syntheticAIdata/JBR-001/schematics/JBR-001-schematics.png

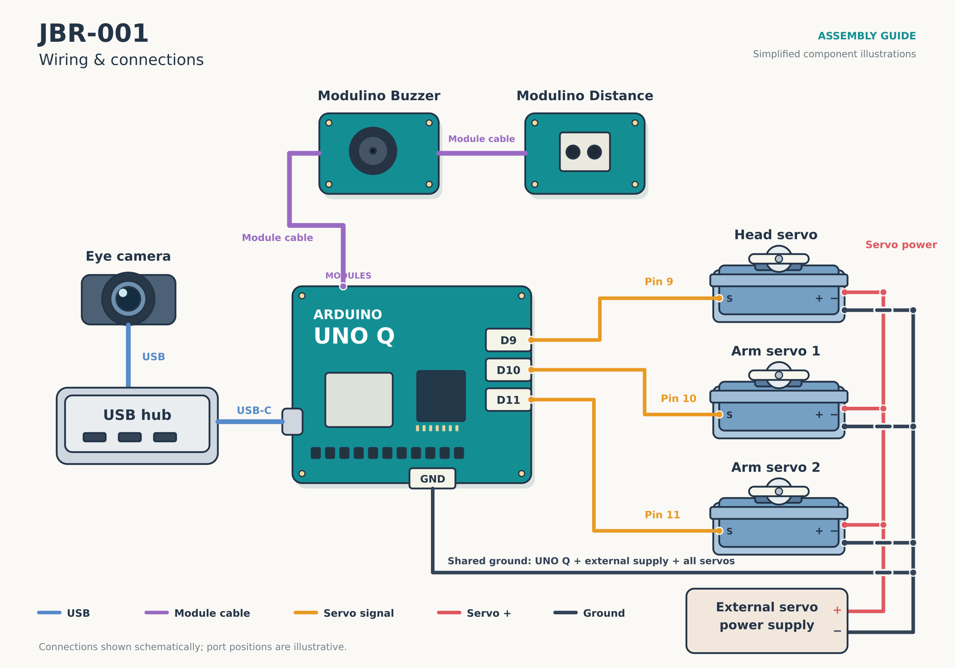
schematics/JBR-001-schematics.png
