syntheticAIdata/JBR-001/3d-printable-files/right-leg/Right_Leg_Main_White.stl

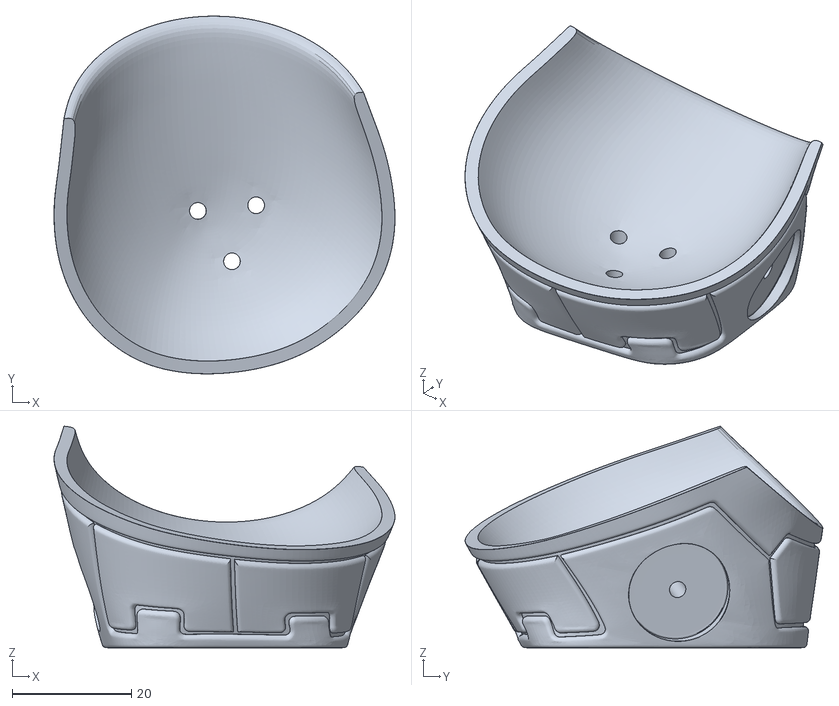
[picture p3: CAD file, 2026-09-22]
3d-printable-files/right-leg/Right_Leg_Main_White.stl
57.3 x 60.1 x 37.2
