syntheticAIdata/JBR-001/3d-printable-files/body/Body_Frame_Front_White.stl

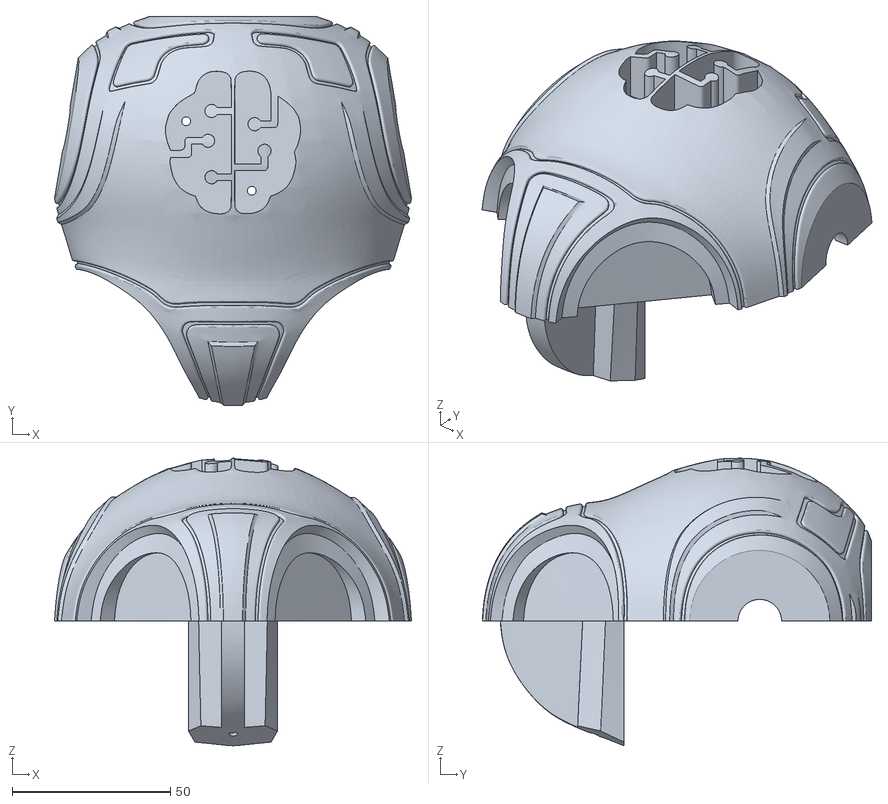
[picture p4: CAD file, 2026-10-07]
3d-printable-files/body/Body_Frame_Front_White.stl
112.8 x 122.9 x 90.8
