syntheticAIdata/JBR-001/3d-printable-files/frame/Frame_Cage_Body_Bottom.stl

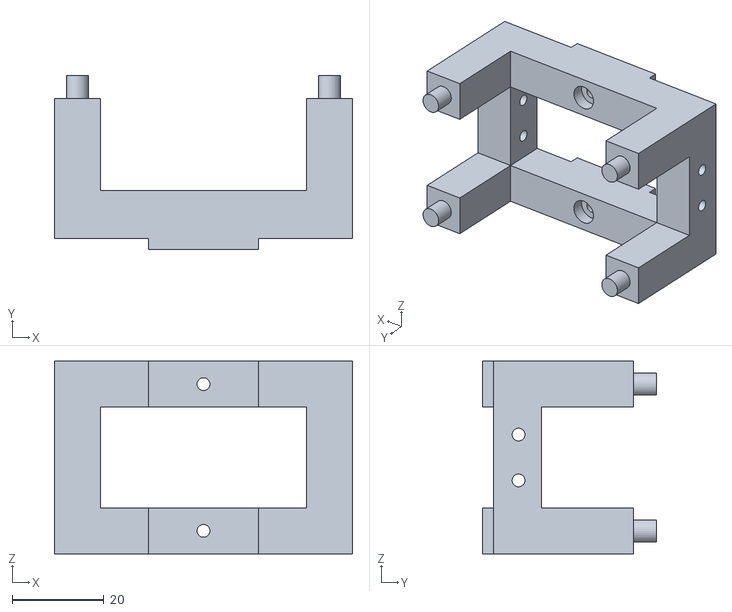
[picture p5: CAD file, 2026-10-07]
3d-printable-files/frame/Frame_Cage_Body_Bottom.stl
65.0 x 37.9 x 42.0
