syntheticAIdata/JBR-001/3d-printable-files/head/Head_Ear_Right_Blue.stl

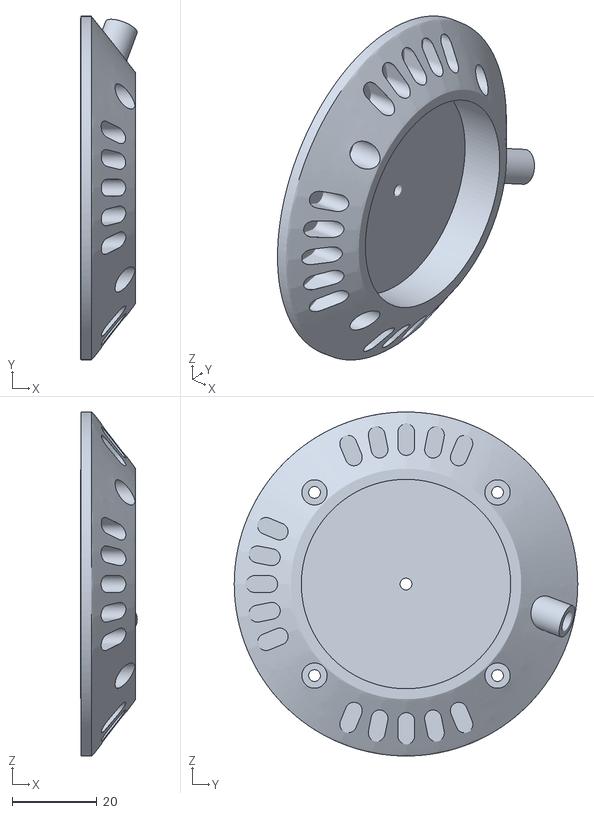
[picture p6: CAD file, 2026-09-22]
3d-printable-files/head/Head_Ear_Right_Blue.stl
13.4 x 81.3 x 81.4
