syntheticAIdata/JBR-001/3d-printable-files/left-arm/Left_Arm_Forearm_White.stl

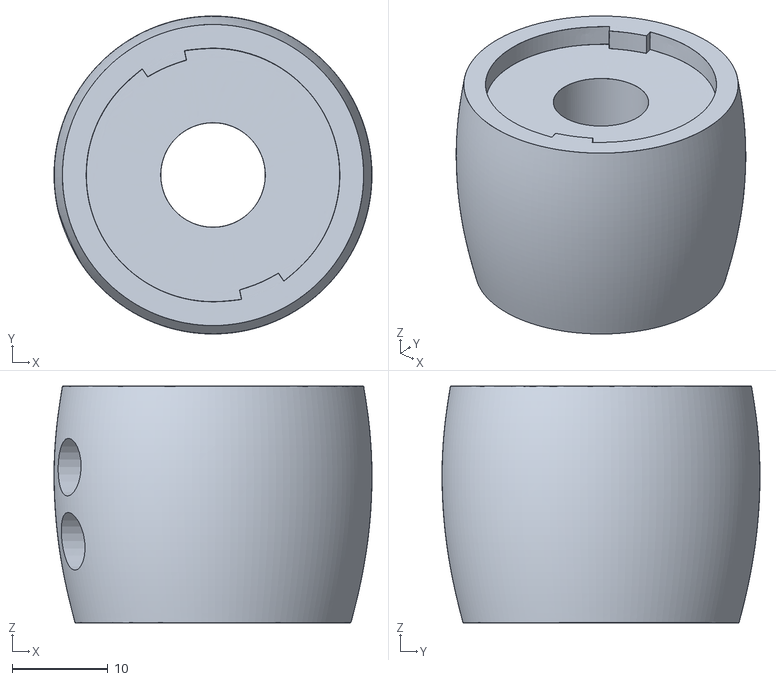
[picture p7: CAD file, 2026-09-22]
3d-printable-files/left-arm/Left_Arm_Forearm_White.stl
33.1 x 33.1 x 24.7
