syntheticAIdata/JBR-001/3d-printable-files/left-leg/Left_Leg_Cap_White.stl

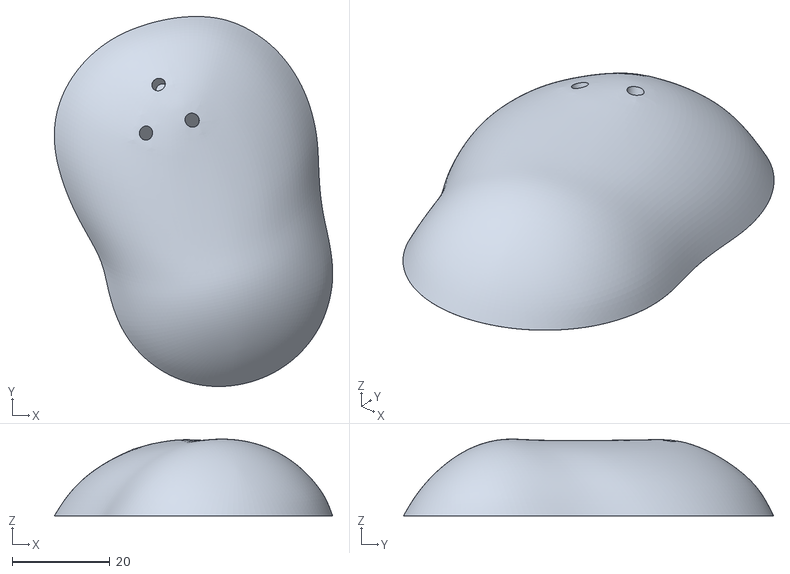
[picture p8: CAD file, 2026-09-22]
3d-printable-files/left-leg/Left_Leg_Cap_White.stl
56.8 x 75.5 x 15.7
