syntheticAIdata/JBR-001/3d-printable-files/right-arm/Right_Arm_Ring_Bottom_Blue.stl

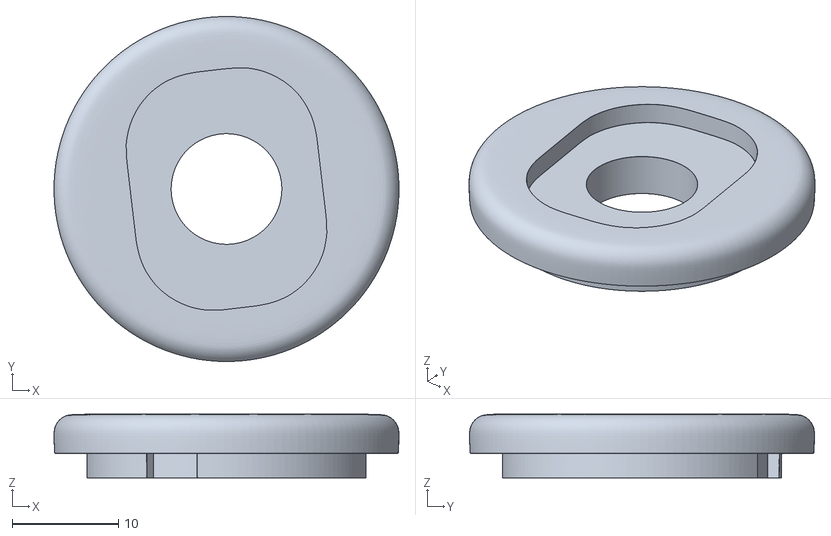
[picture p9: CAD file, 2026-09-22]
3d-printable-files/right-arm/Right_Arm_Ring_Bottom_Blue.stl
32.5 x 32.5 x 6.03
