syntheticAIdata/JBR-001/3d-printable-files/right-leg/Right_Leg_Knee_Ring_Blue.stl

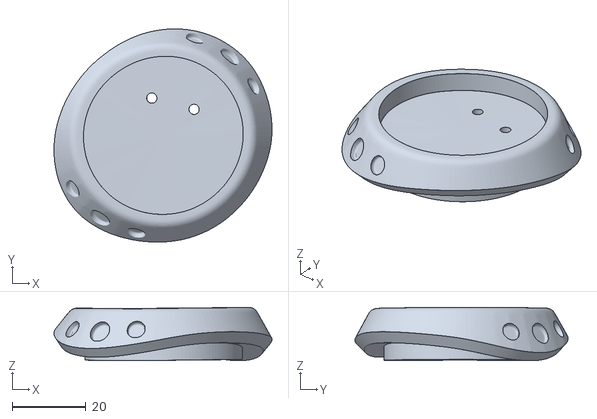
[picture p10: CAD file, 2026-09-22]
3d-printable-files/right-leg/Right_Leg_Knee_Ring_Blue.stl
59.1 x 57.8 x 14.5
