syntheticAIdata/JBR-001/3d-printable-files/body/Body_Frame_Back_White.stl

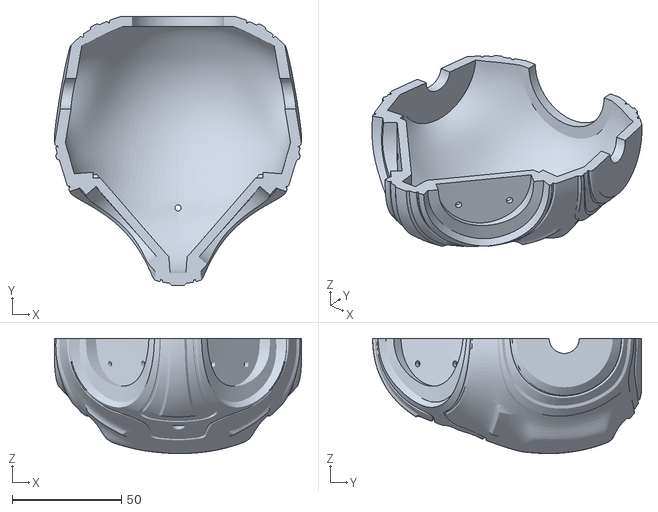
[picture p11: CAD file, 2026-10-07]
3d-printable-files/body/Body_Frame_Back_White.stl
113.1 x 123.0 x 52.7
