syntheticAIdata/JBR-001/3d-printable-files/frame/Frame_Head_Back_Bottom_Left.stl

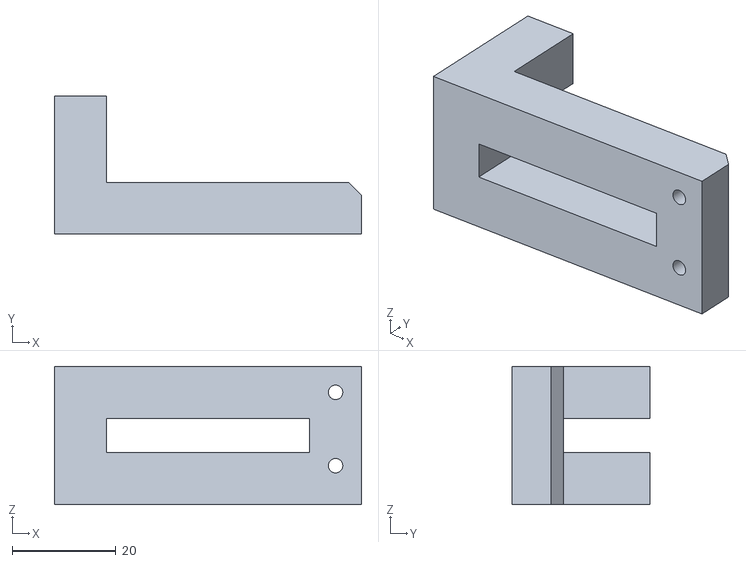
[picture p12: CAD file, 2026-09-22]
3d-printable-files/frame/Frame_Head_Back_Bottom_Left.stl
59.3 x 26.7 x 26.7
