syntheticAIdata/JBR-001/3d-printable-files/head/Head_Front_Right_White.stl

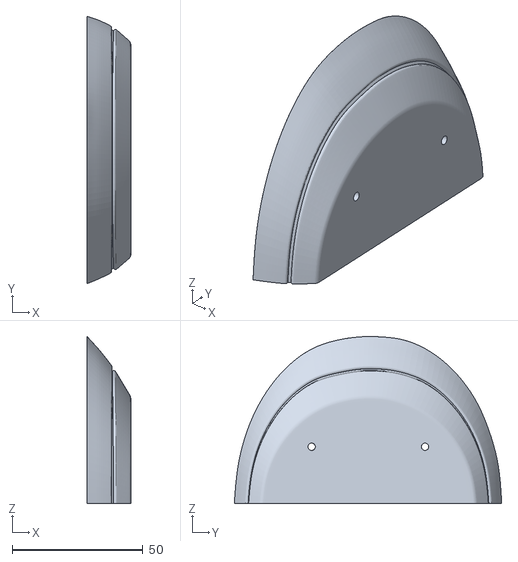
[picture p13: CAD file, 2026-09-22]
3d-printable-files/head/Head_Front_Right_White.stl
16.7 x 102.1 x 63.8
