syntheticAIdata/JBR-001/3d-printable-files/left-arm/Left_Arm_Shoulder_White.stl

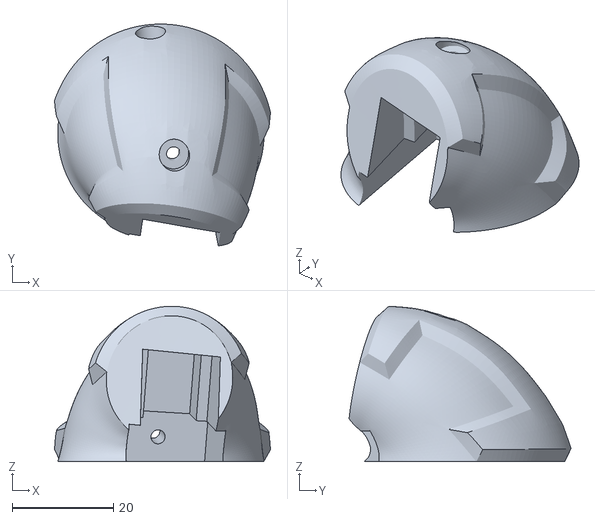
[picture p14: CAD file, 2026-09-22]
3d-printable-files/left-arm/Left_Arm_Shoulder_White.stl
42.6 x 43.8 x 30.7
