syntheticAIdata/JBR-001/3d-printable-files/left-leg/Left_Leg_Base_Blue.stl

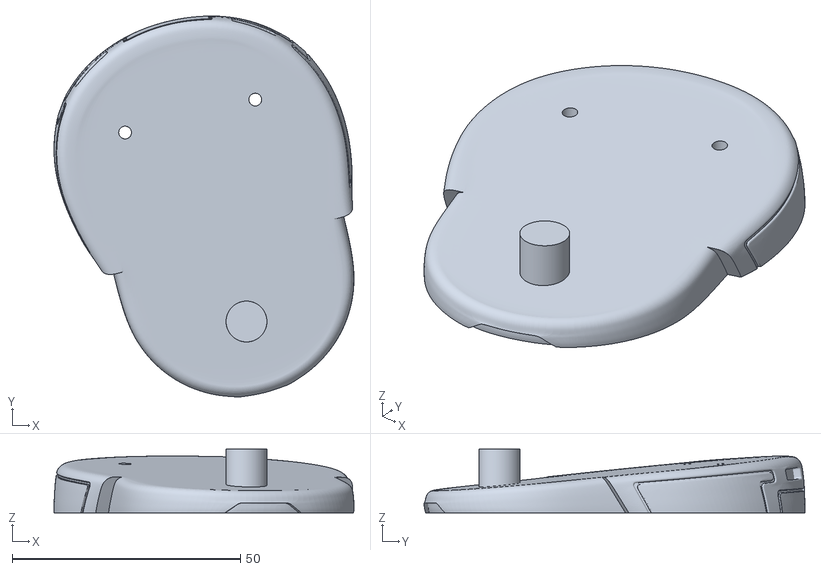
[picture p15: CAD file, 2026-09-22]
3d-printable-files/left-leg/Left_Leg_Base_Blue.stl
65.7 x 83.4 x 13.9
