syntheticAIdata/JBR-001/3d-printable-files/body/Body_Logo_Left_Blue.stl

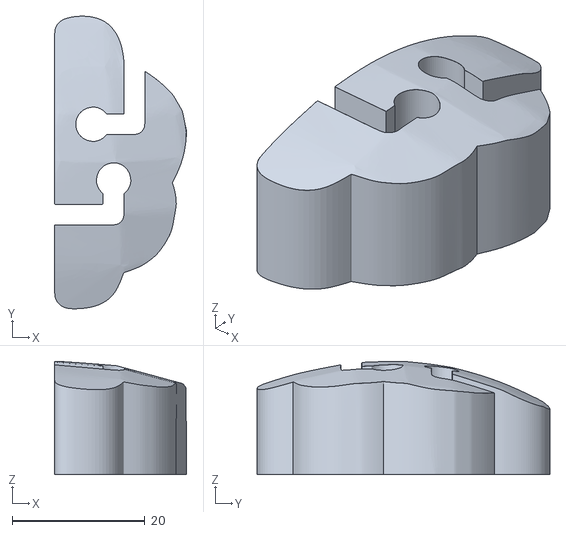
[picture p16: CAD file, 2026-09-22]
3d-printable-files/body/Body_Logo_Left_Blue.stl
19.9 x 44.0 x 17.0
