syntheticAIdata/JBR-001/3d-printable-files/frame/Frame_Holder_Back_Cap_Left_Blue.stl

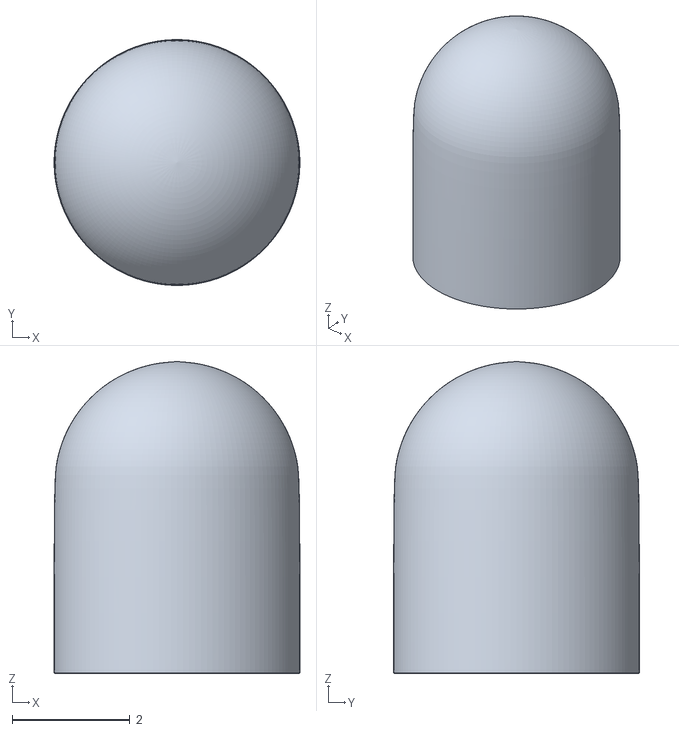
[picture p17: CAD file, 2026-09-22]
3d-printable-files/frame/Frame_Holder_Back_Cap_Left_Blue.stl
4.18 x 4.18 x 5.31
