syntheticAIdata/JBR-001/3d-printable-files/head/Head_Ear_Button_Right_White.stl

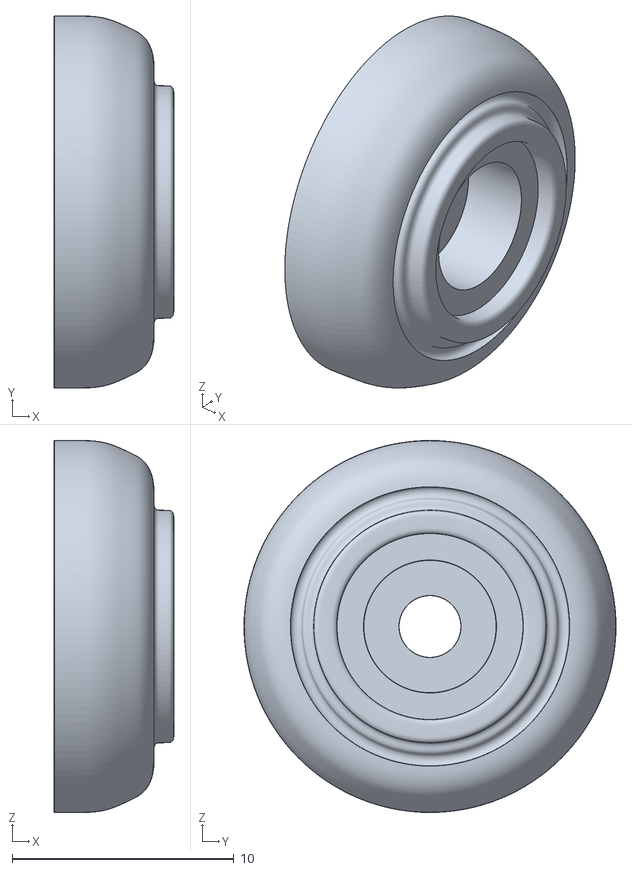
[picture p18: CAD file, 2026-09-22]
3d-printable-files/head/Head_Ear_Button_Right_White.stl
5.40 x 16.8 x 16.8
