syntheticAIdata/JBR-001/3d-printable-files/left-arm/Left_Arm_Shoulder_Pole.stl

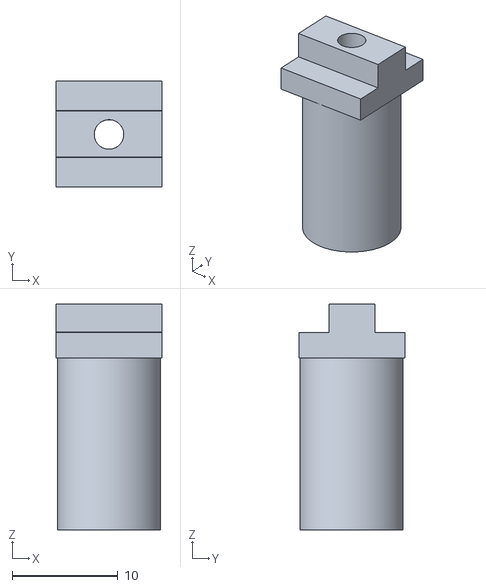
[picture p19: CAD file, 2026-09-22]
3d-printable-files/left-arm/Left_Arm_Shoulder_Pole.stl
10.0 x 10.0 x 21.4
