syntheticAIdata/JBR-001/3d-printable-files/right-arm/Right_Arm_Upper_Arm_Black.stl

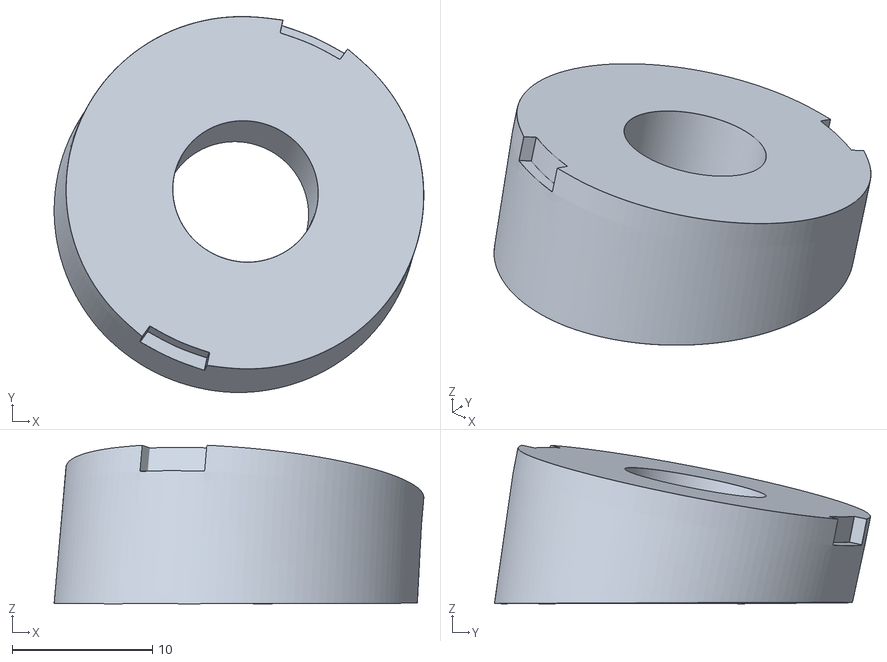
[picture p20: CAD file, 2026-09-22]
3d-printable-files/right-arm/Right_Arm_Upper_Arm_Black.stl
26.3 x 26.8 x 11.3
