syntheticAIdata/JBR-001/3d-printable-files/right-leg/Right_Leg_Knee_Black.stl

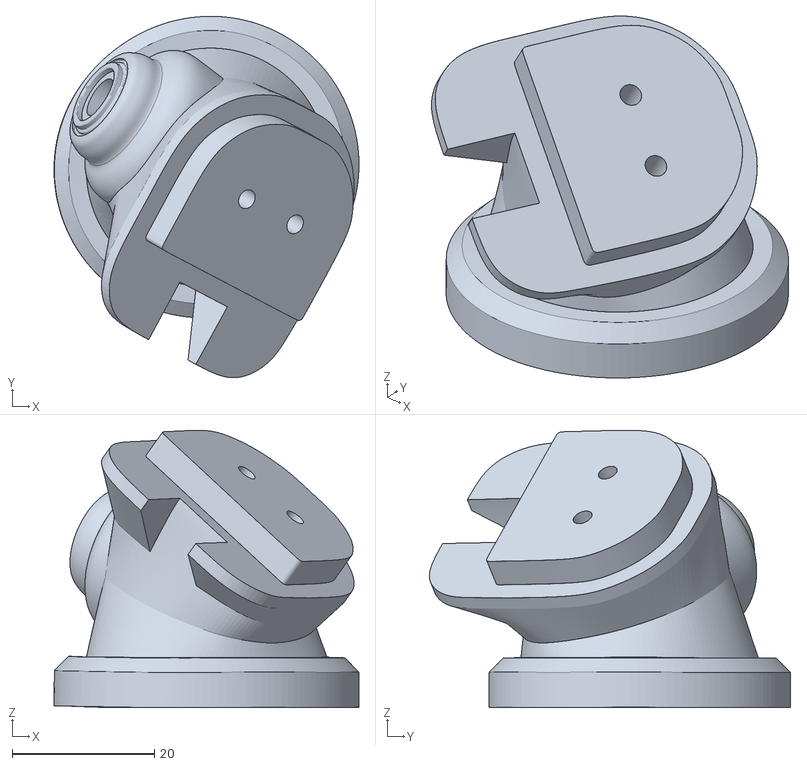
[picture p21: CAD file, 2026-09-22]
3d-printable-files/right-leg/Right_Leg_Knee_Black.stl
42.9 x 50.8 x 39.0
