syntheticAIdata/JBR-001/3d-printable-files/frame/Frame_Gear_18_teeth.stl

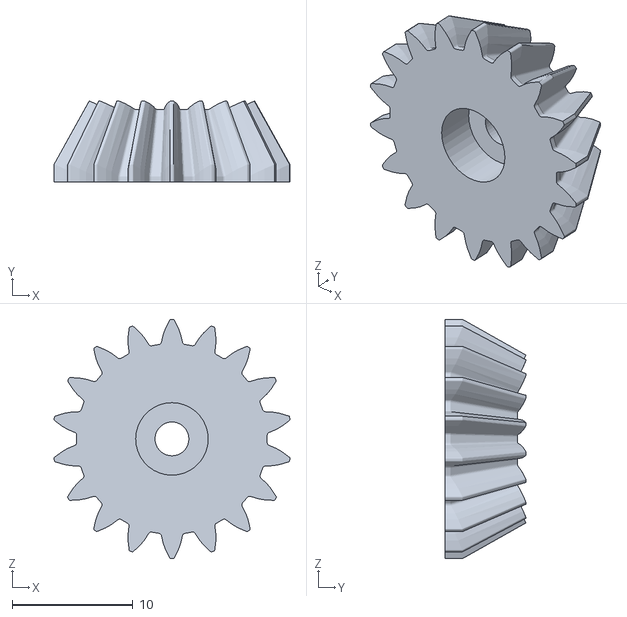
[picture p22: CAD file, 2026-09-22]
3d-printable-files/frame/Frame_Gear_18_teeth.stl
19.5 x 6.68 x 19.8
