syntheticAIdata/JBR-001/3d-printable-files/head/Head_Ear_Inside_Right_Blue.stl

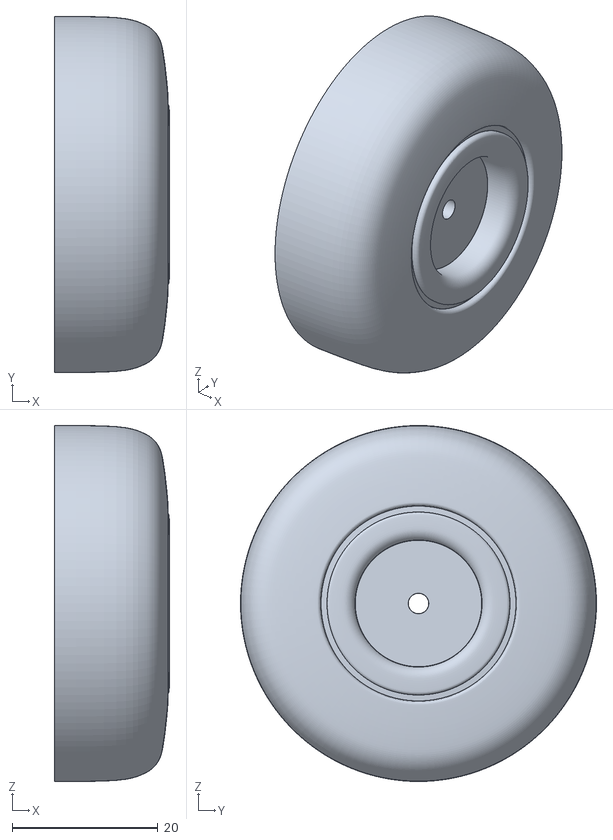
[picture p23: CAD file, 2026-09-22]
3d-printable-files/head/Head_Ear_Inside_Right_Blue.stl
15.8 x 48.8 x 48.8
