syntheticAIdata/JBR-001/3d-printable-files/left-leg/Left_Leg_Ring_Blue.stl

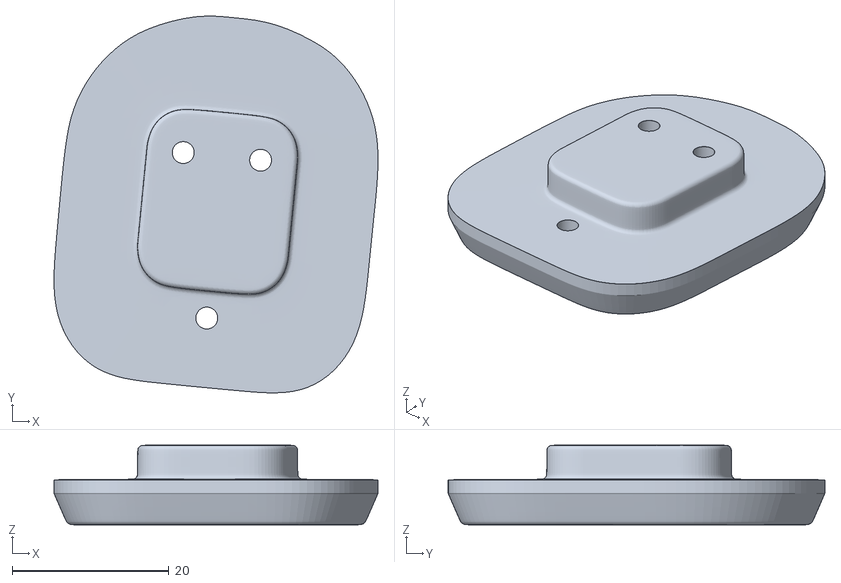
[picture p24: CAD file, 2026-09-22]
3d-printable-files/left-leg/Left_Leg_Ring_Blue.stl
41.3 x 48.0 x 10.2
