syntheticAIdata/JBR-001/3d-printable-files/right-arm/Right_Arm_Ring_Top_Blue.stl

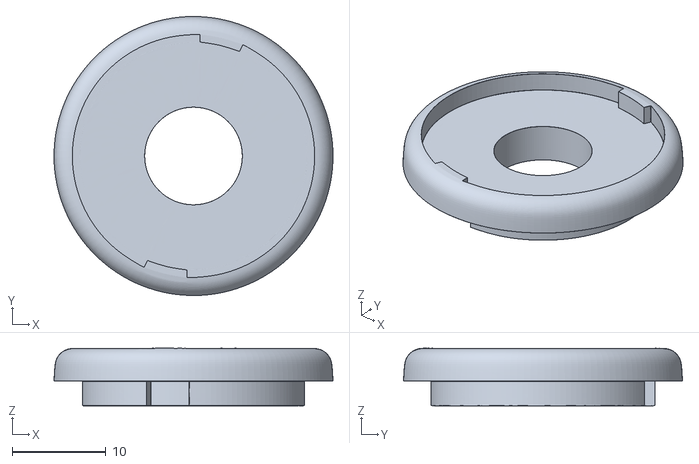
[picture p25: CAD file, 2026-09-22]
3d-printable-files/right-arm/Right_Arm_Ring_Top_Blue.stl
29.8 x 29.8 x 6.14
