syntheticAIdata/JBR-001/3d-printable-files/frame/Frame_Pole_Barrel_Back.stl

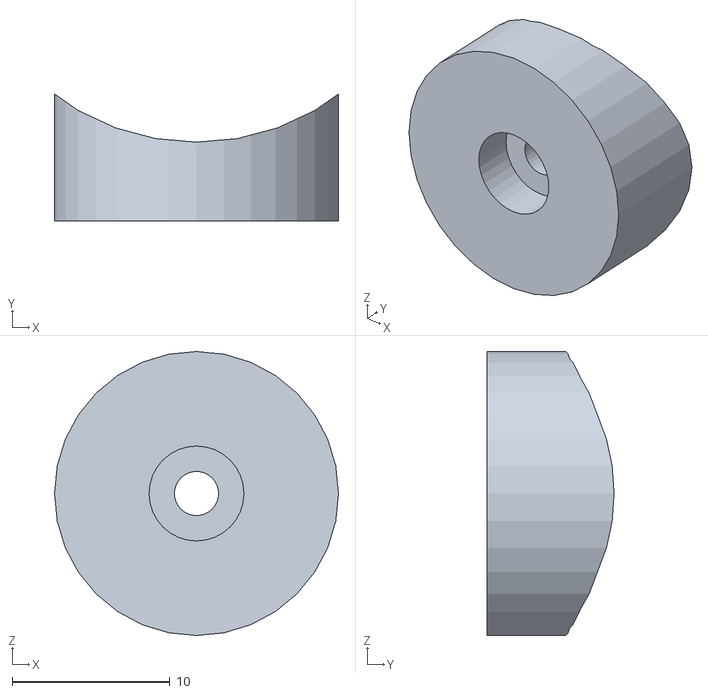
[picture p26: CAD file, 2026-09-22]
3d-printable-files/frame/Frame_Pole_Barrel_Back.stl
18.0 x 8.06 x 18.0
