syntheticAIdata/JBR-001/3d-printable-files/left-arm/Left_Arm_Shoulder_Joint.stl

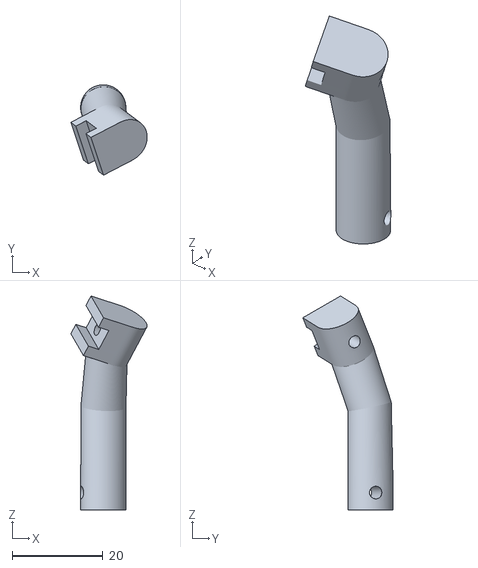
[picture p28: CAD file, 2026-09-22]
3d-printable-files/left-arm/Left_Arm_Shoulder_Joint.stl
16.8 x 19.9 x 47.1
