syntheticAIdata/JBR-001/3d-printable-files/right-arm/Right_Arm_Hand_Gray.stl

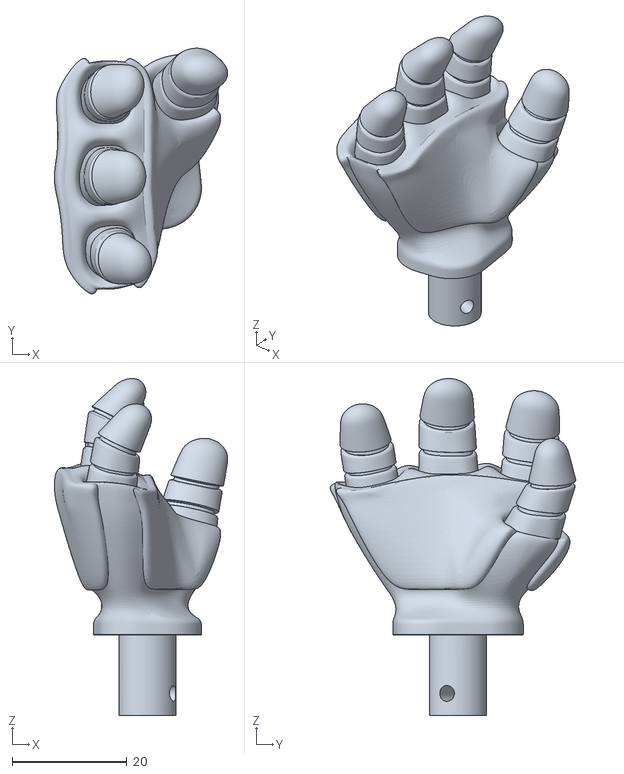
[picture p29: CAD file, 2026-09-22]
3d-printable-files/right-arm/Right_Arm_Hand_Gray.stl
30.2 x 42.9 x 58.8
