syntheticAIdata/JBR-001/3d-printable-files/head/Head_Front_White.stl

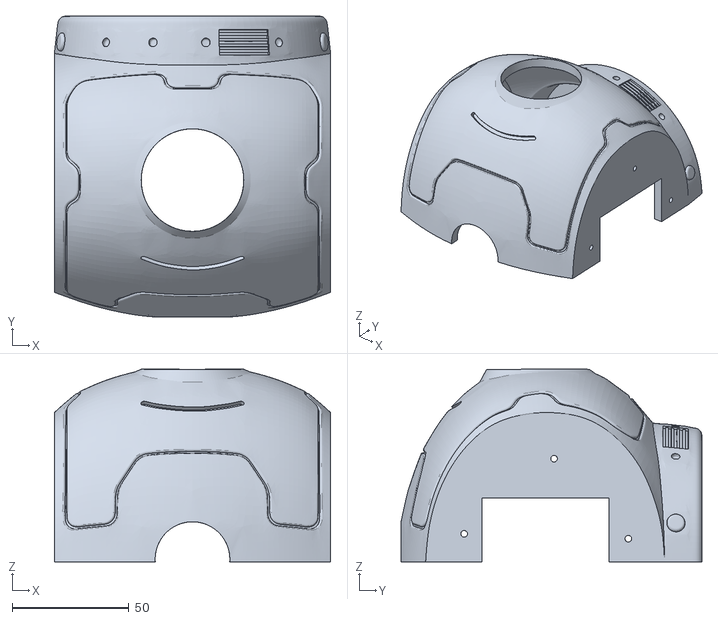
[picture p30: CAD file, 2026-09-22]
3d-printable-files/head/Head_Front_White.stl
118.1 x 128.6 x 82.3
