syntheticAIdata/JBR-001/3d-printable-files/frame/Frame_Head_Front_Bottom_Right.stl

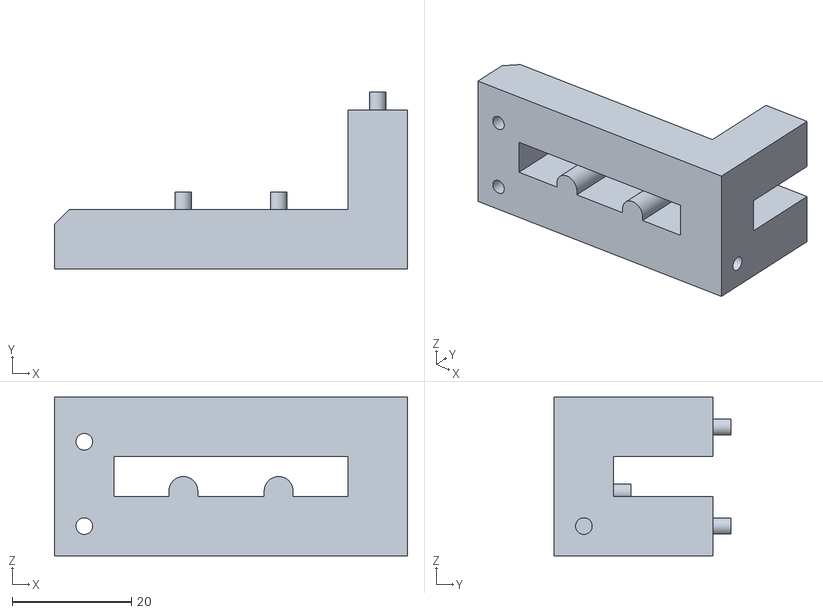
[picture p31: CAD file, 2026-09-22]
3d-printable-files/frame/Frame_Head_Front_Bottom_Right.stl
59.3 x 29.7 x 26.7
