syntheticAIdata/JBR-001/3d-printable-files/head/Head_Back_Left_White.stl

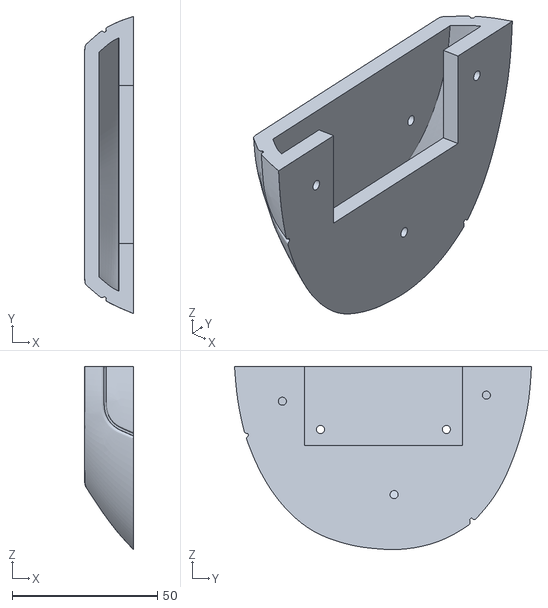
[picture p32: CAD file, 2026-09-22]
3d-printable-files/head/Head_Back_Left_White.stl
16.7 x 102.1 x 63.0
