syntheticAIdata/JBR-001/3d-printable-files/left-arm/Left_Arm_Shoulder_Ring_Blue.stl

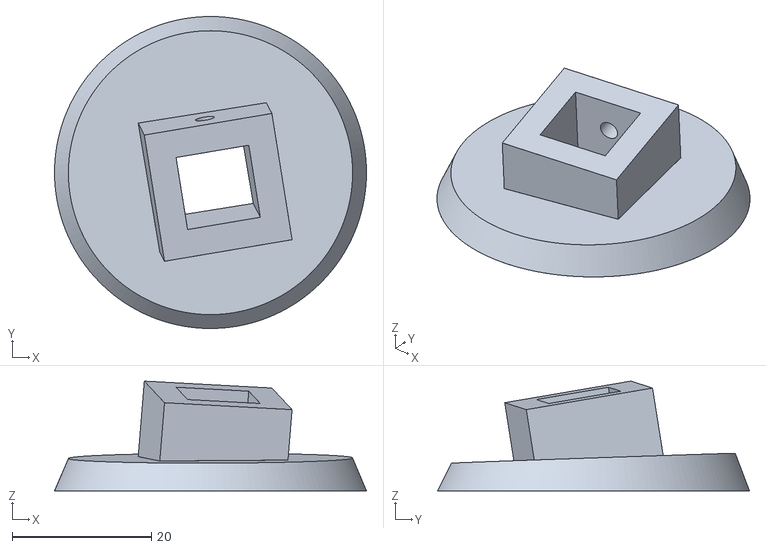
[picture p33: CAD file, 2026-09-22]
3d-printable-files/left-arm/Left_Arm_Shoulder_Ring_Blue.stl
44.8 x 44.8 x 15.8
