syntheticAIdata/JBR-001/3d-printable-files/frame/Frame_Head_Camera_Holder.stl

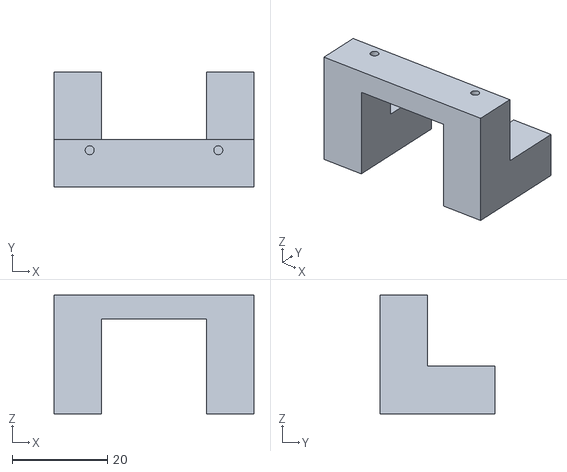
[picture p34: CAD file, 2026-09-22]
3d-printable-files/frame/Frame_Head_Camera_Holder.stl
42.0 x 24.2 x 24.9
