syntheticAIdata/JBR-001/3d-printable-files/frame/Frame_Cage_Body_Top.stl

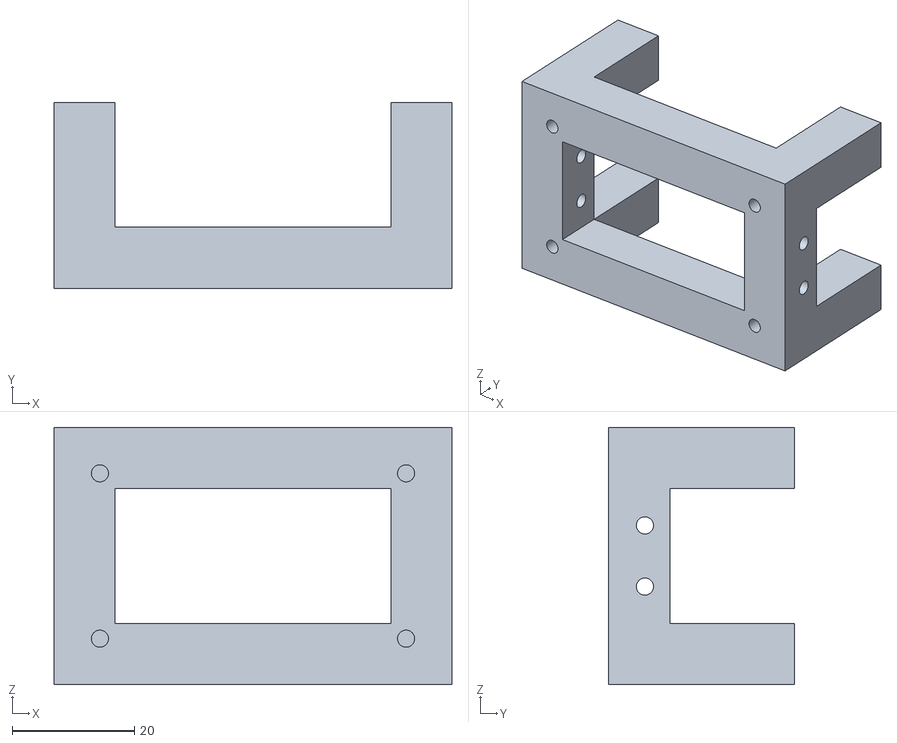
[picture p35: CAD file, 2026-09-22]
3d-printable-files/frame/Frame_Cage_Body_Top.stl
65.0 x 30.4 x 42.0
