syntheticAIdata/JBR-001/3d-printable-files/frame/Frame_Head_Servo_Middle.stl

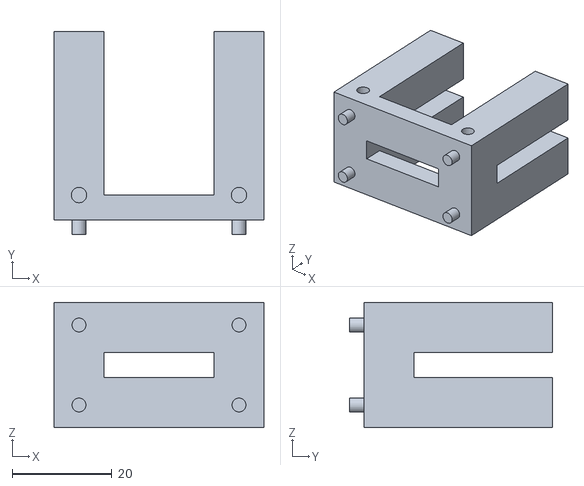
[picture p36: CAD file, 2026-09-22]
3d-printable-files/frame/Frame_Head_Servo_Middle.stl
42.0 x 40.7 x 25.0
