syntheticAIdata/JBR-001/3d-printable-files/head/Head_Antenna_Right_White.stl

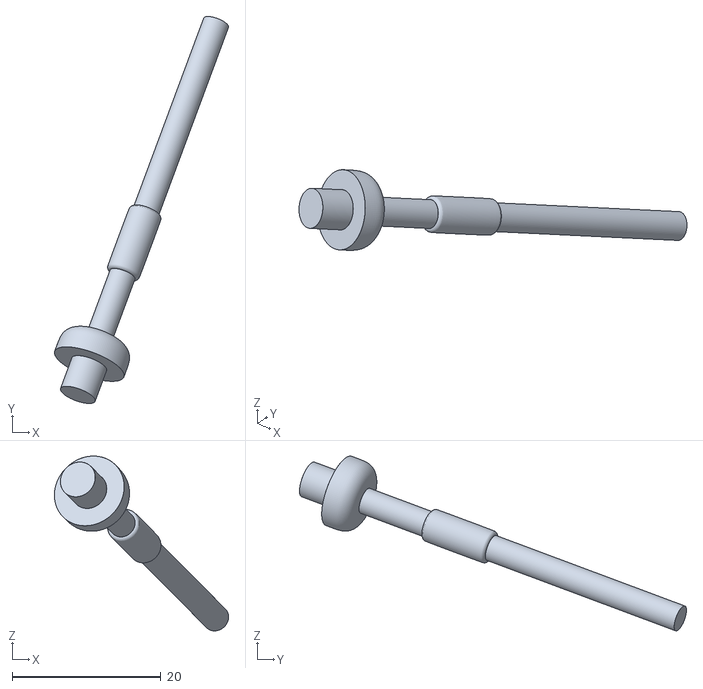
[picture p37: CAD file, 2026-09-22]
3d-printable-files/head/Head_Antenna_Right_White.stl
23.4 x 52.0 x 23.5
