syntheticAIdata/JBR-001/3d-printable-files/frame/Frame_Pole_White.stl

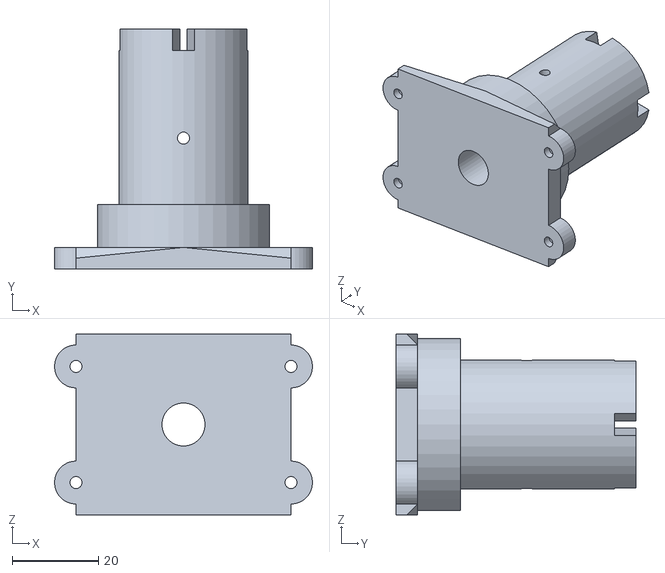
[picture p38: CAD file, 2026-09-22]
3d-printable-files/frame/Frame_Pole_White.stl
60.0 x 55.8 x 42.0
