syntheticAIdata/JBR-001/3d-printable-files/frame/Frame_Head_Servo_Top.stl

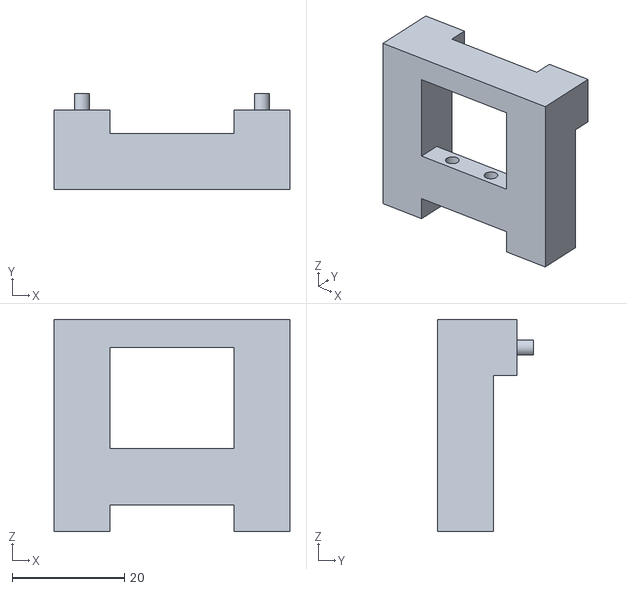
[picture p39: CAD file, 2026-09-22]
3d-printable-files/frame/Frame_Head_Servo_Top.stl
42.0 x 17.2 x 37.7
