syntheticAIdata/JBR-001/3d-printable-files/head/Head_Camera_Lens_Black.stl

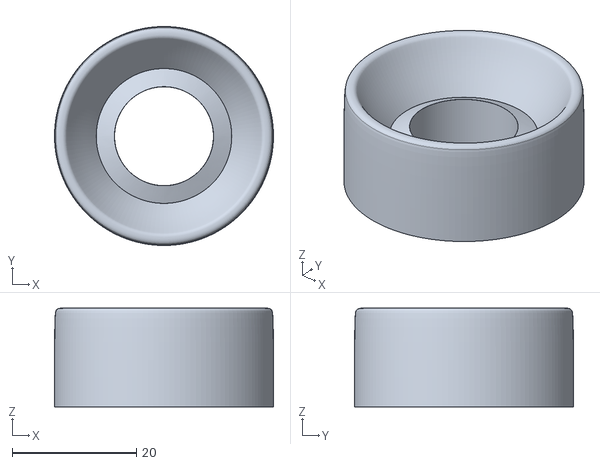
[picture p40: CAD file, 2026-09-22]
3d-printable-files/head/Head_Camera_Lens_Black.stl
35.2 x 35.2 x 15.9
