syntheticAIdata/JBR-001/3d-printable-files/frame/Frame_Holder_Back_Blue.stl

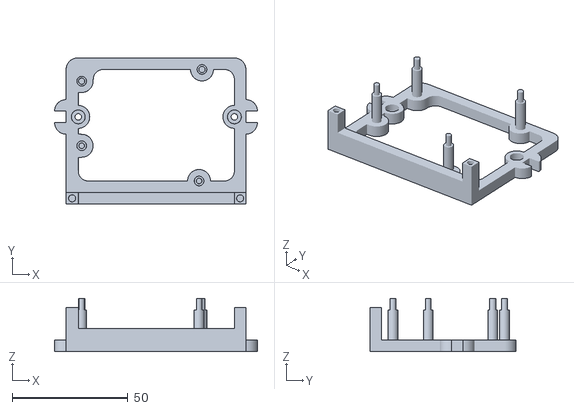
[picture p41: CAD file, 2026-09-22]
3d-printable-files/frame/Frame_Holder_Back_Blue.stl
87.8 x 63.3 x 23.0
