syntheticAIdata/JBR-001/3d-printable-files/head/Head_Antenna_Cap_Left_Blue.stl

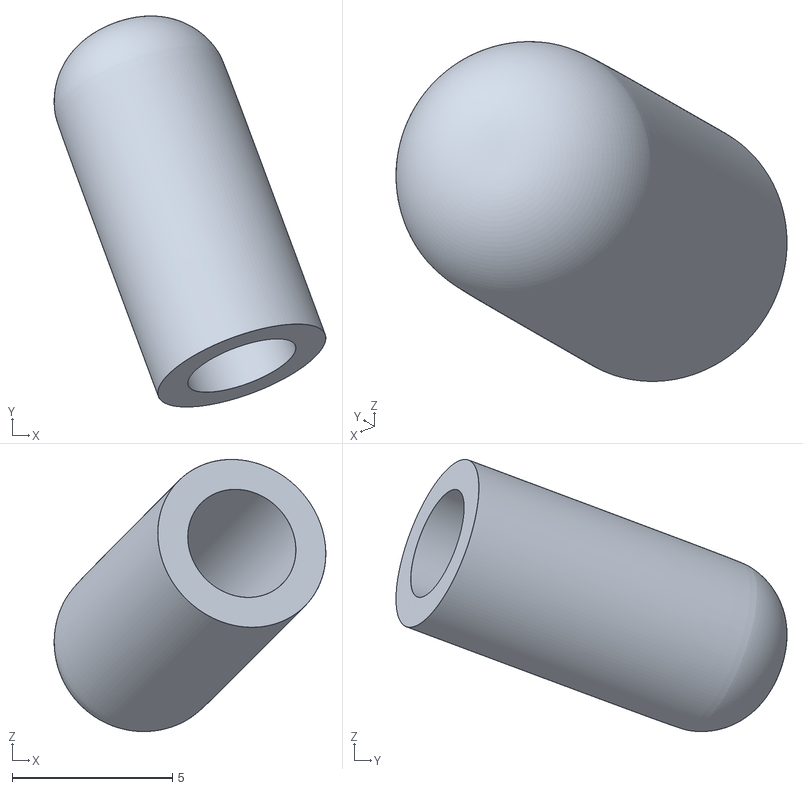
[picture p42: CAD file, 2026-09-22]
3d-printable-files/head/Head_Antenna_Cap_Left_Blue.stl
8.49 x 12.2 x 8.50
