syntheticAIdata/JBR-001/3d-printable-files/head/Head_Back_Ring_Blue.stl

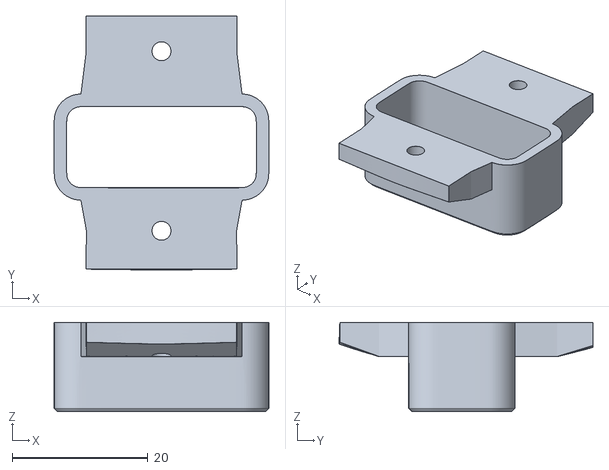
[picture p43: CAD file, 2026-09-22]
3d-printable-files/head/Head_Back_Ring_Blue.stl
31.7 x 37.5 x 13.2
