syntheticAIdata/JBR-001/3d-printable-files/head/Head_Camera_Lens_Ring_Blue.stl

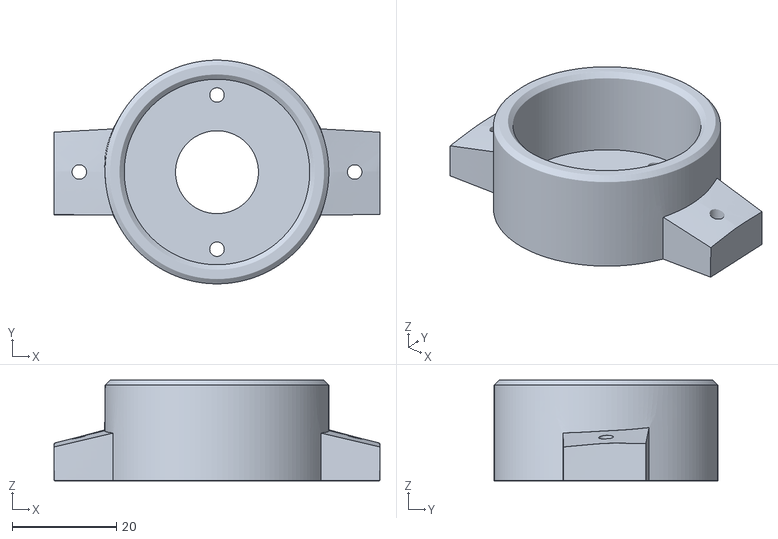
[picture p44: CAD file, 2026-09-22]
3d-printable-files/head/Head_Camera_Lens_Ring_Blue.stl
62.6 x 42.9 x 19.3
