syntheticAIdata/JBR-001/3d-printable-files/frame/Frame_Gear_36_teeth.stl

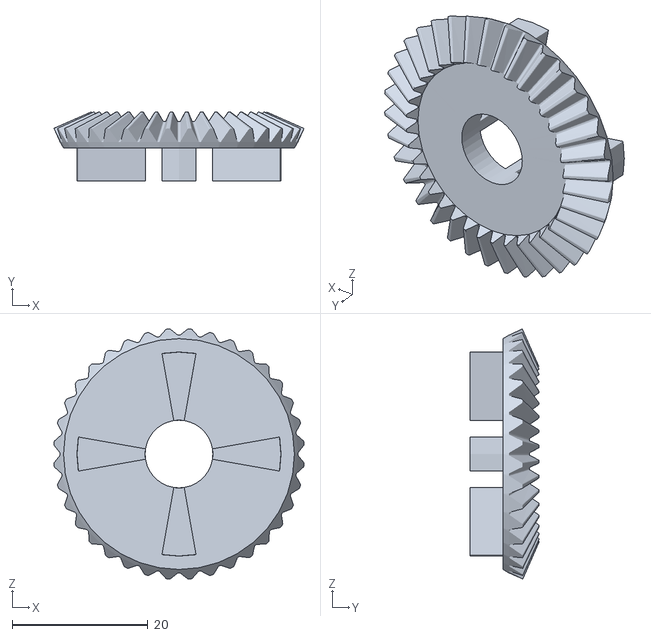
[picture p45: CAD file, 2026-09-22]
3d-printable-files/frame/Frame_Gear_36_teeth.stl
36.8 x 10.2 x 36.8
