syntheticAIdata/JBR-001/3d-printable-files/frame/Frame_Holder_Front_Blue.stl

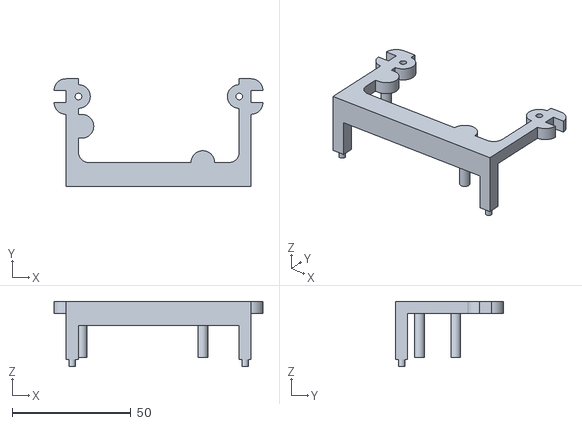
[picture p46: CAD file, 2026-09-22]
3d-printable-files/frame/Frame_Holder_Front_Blue.stl
87.8 x 45.2 x 27.3
