syntheticAIdata/JBR-001/(list of files, cad)

Other CAD files:
3d-printable-files/left-leg/Left_Leg_Main_White.stl
3d-printable-files/right-arm/Right_Arm_Forearm_White.stl
3d-printable-files/left-leg/Left_Leg_Button_Right_Blue.stl
3d-printable-files/body/Body_Logo_Right_Blue.stl
3d-printable-files/left-arm/Left_Arm_Ring_Bottom_Blue.stl
3d-printable-files/right-leg/Right_Leg_Button_Left_Blue.stl
3d-printable-files/left-leg/Left_Leg_Knee_Black.stl
3d-printable-files/right-leg/Right_Leg_Base_Blue.stl
3d-printable-files/frame/Frame_Head_Back_Bottom_Right.stl
3d-printable-files/head/Head_Ear_Inside_Left_Blue.stl
3d-printable-files/left-arm/Left_Arm_Ring_Top_Blue.stl
3d-printable-files/left-leg/Left_Leg_Knee_Ring_Blue.stl
3d-printable-files/right-arm/Right_Arm_Shoulder_Joint.stl
3d-printable-files/right-leg/Right_Leg_Ring_Blue.stl
3d-printable-files/frame/Frame_Head_Back_Top_Right.stl
3d-printable-files/left-arm/Left_Arm_Hand_Gray.stl
3d-printable-files/right-arm/Right_Arm_Shoulder_White.stl
3d-printable-files/right-leg/Right_Leg_Button_Right_Blue.stl
3d-printable-files/left-leg/Left_Leg_Button_Left_Blue.stl
3d-printable-files/right-arm/Right_Arm_Shoulder_Ring_Blue.stl
3d-printable-files/right-leg/Right_Leg_Cap_White.stl
3d-printable-files/frame/Frame_Head_Front_Top_Left.stl
3d-printable-files/head/Head_Back_Right_White.stl
3d-printable-files/left-arm/Left_Arm_Upper_Arm_Black.stl
3d-printable-files/right-arm/Right_Arm_Shoulder_Pole.stl
3d-printable-files/head/Head_Ear_Button_Left_White.stl
3d-printable-files/head/Head_Front_Left_White.stl
3d-printable-files/head/Head_Antenna_Left_White.stl
3d-printable-files/frame/Frame_Head_Front_Top_Right.stl
3d-printable-files/head/Head_Ear_Left_Blue.stl
3d-printable-files/frame/Frame_Holder_Back_Cap_Right_Blue.stl
3d-printable-files/frame/Frame_Head_Back_Top_Left.stl
3d-printable-files/frame/Frame_Pole_Barrel_Front.stl
3d-printable-files/head/Head_Antenna_Cap_Right_Blue.stl
3d-printable-files/frame/Frame_Head_Servo_Bottom.stl
3d-printable-files/frame/Frame_Head_Front_Bottom_Left.stl
