syntheticAIdata/JBR-001/assembly-instructions/assembly-instructions.pdf

# JBR-001

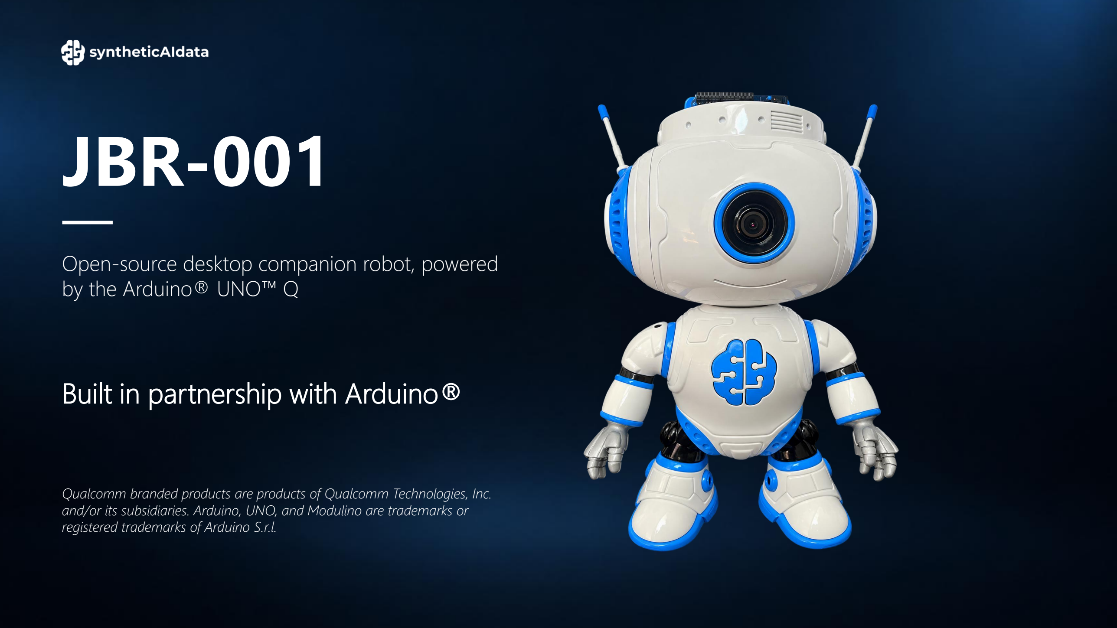
[picture p47: page 1]

Open-source desktop companion robot, powered by the Arduino® UNO Q

## Built in partnership with Arduino®

Qualcomm branded products are products of Qualcomm Technologies, Inc. and/or its subsidiaries. Arduino, UNO, and Modulino are trademarks or registered trademarks of Arduino S.r.l.

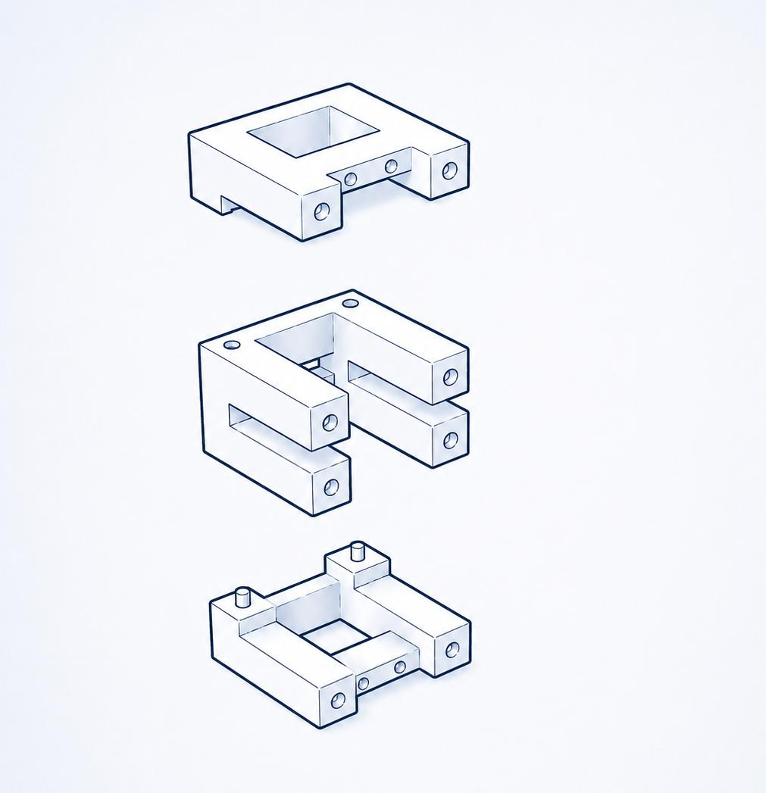
[picture p48: figure]

# ASSEMBLY INSTRUCTIONS

## HEAD FRAME

Frame_Head_Servo_Top
Frame_Head_Servo_Middle
Frame_Head_Servo_Bottom

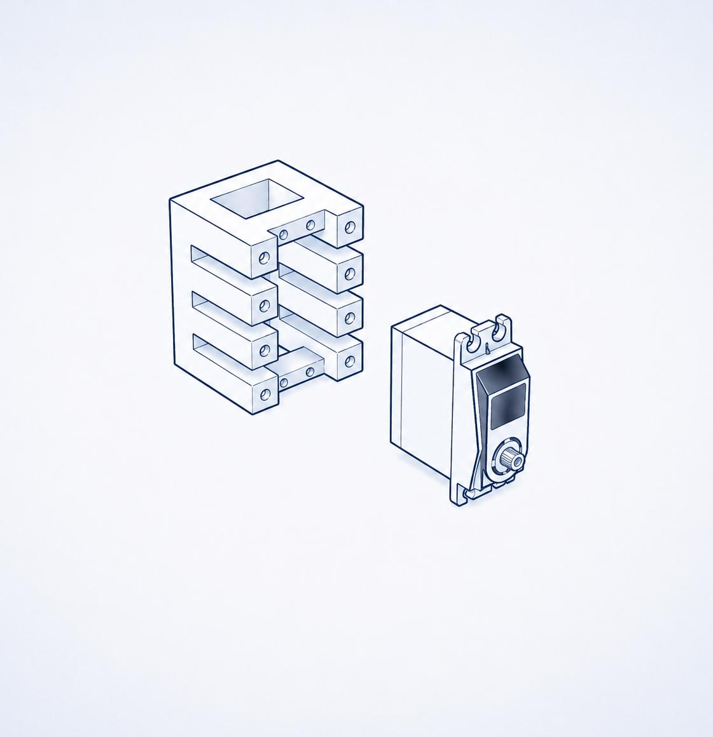
[picture p49: figure]

# ASSEMBLY INSTRUCTIONS

## HEAD FRAME

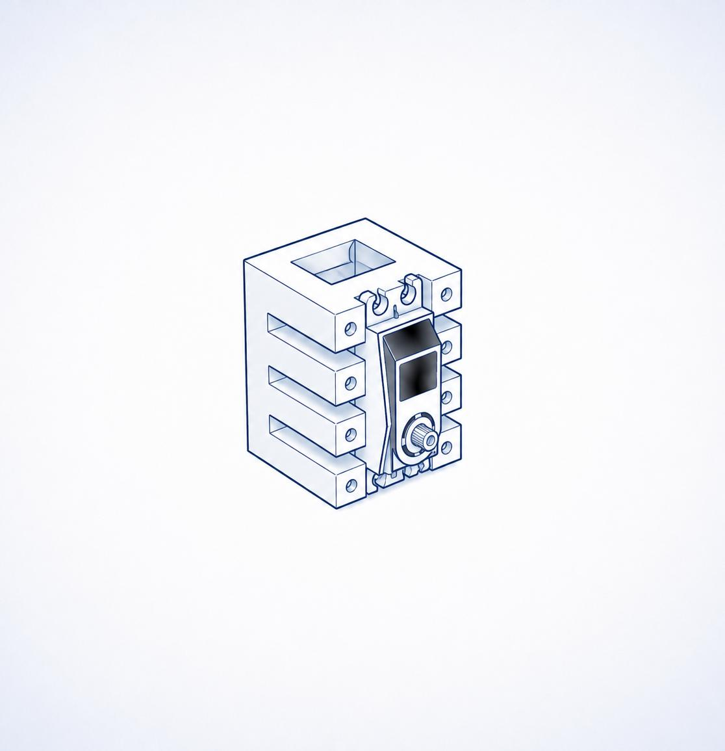
[picture p50: figure]

# ASSEMBLY INSTRUCTIONS

## HEAD FRAME

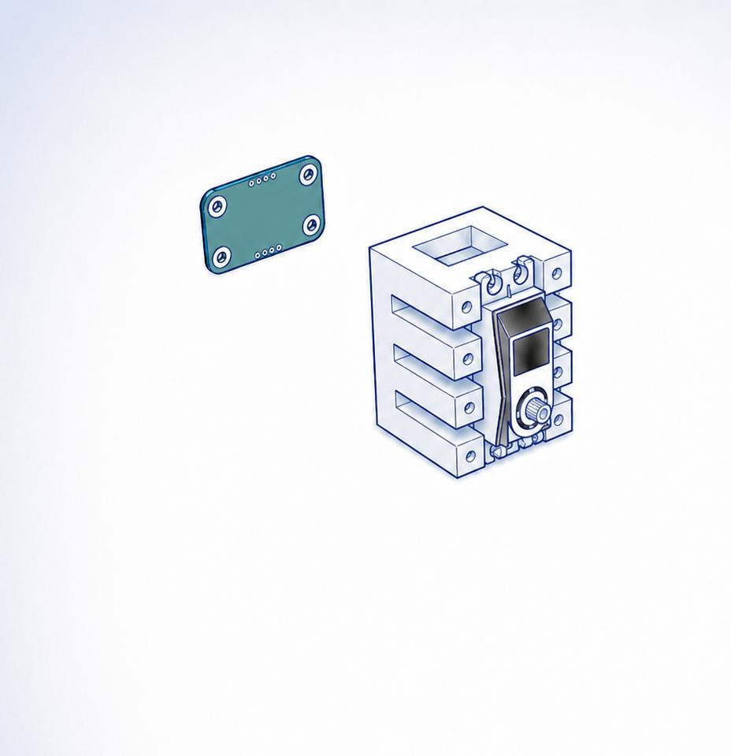
[picture p51: figure]

# ASSEMBLY INSTRUCTIONS

## HEAD FRAME

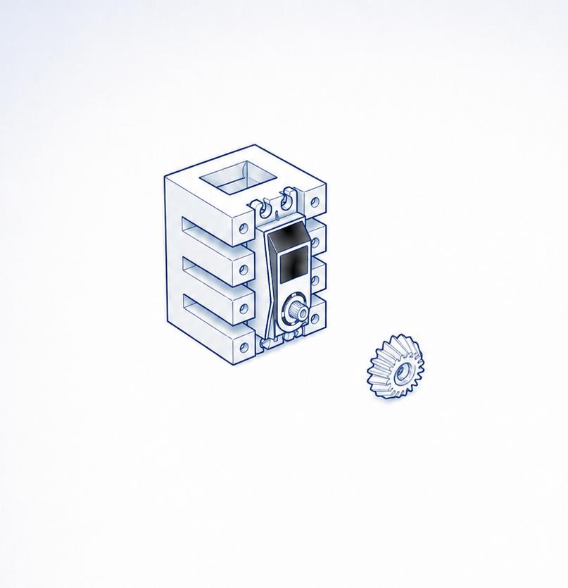
[picture p52: figure]

# ASSEMBLY INSTRUCTIONS

## HEAD FRAME

Frame_Gear_18_teeth

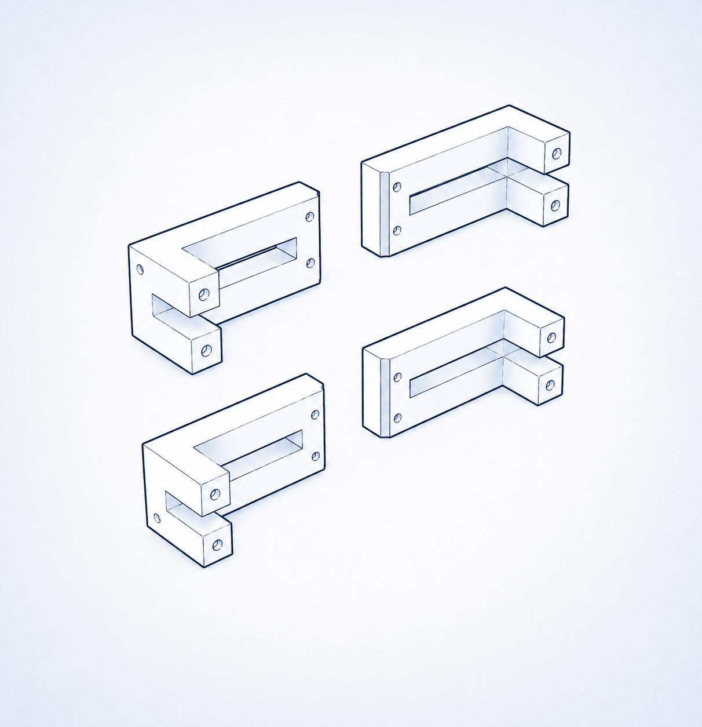
[picture p53: figure]

# ASSEMBLY INSTRUCTIONS

## HEAD FRAME

Frame_Head_Back_Bottom_Left Frame_Head_Back_Bottom_Right Frame_Head_Back_Top_Left
Frame_Head_Back_Top_Right

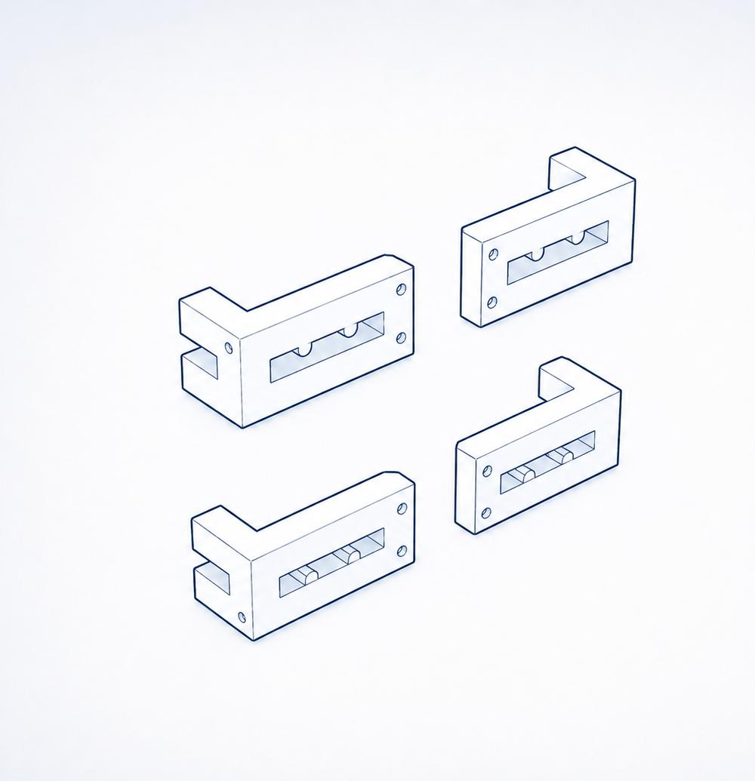
[picture p54: figure]

# ASSEMBLY INSTRUCTIONS

## HEAD FRAME

Frame_Head_Front_Bottom_Left Frame_Head_Front_Bottom_Right Frame_Head_Front_Top_Left
Frame_Head_Front_Top_Right

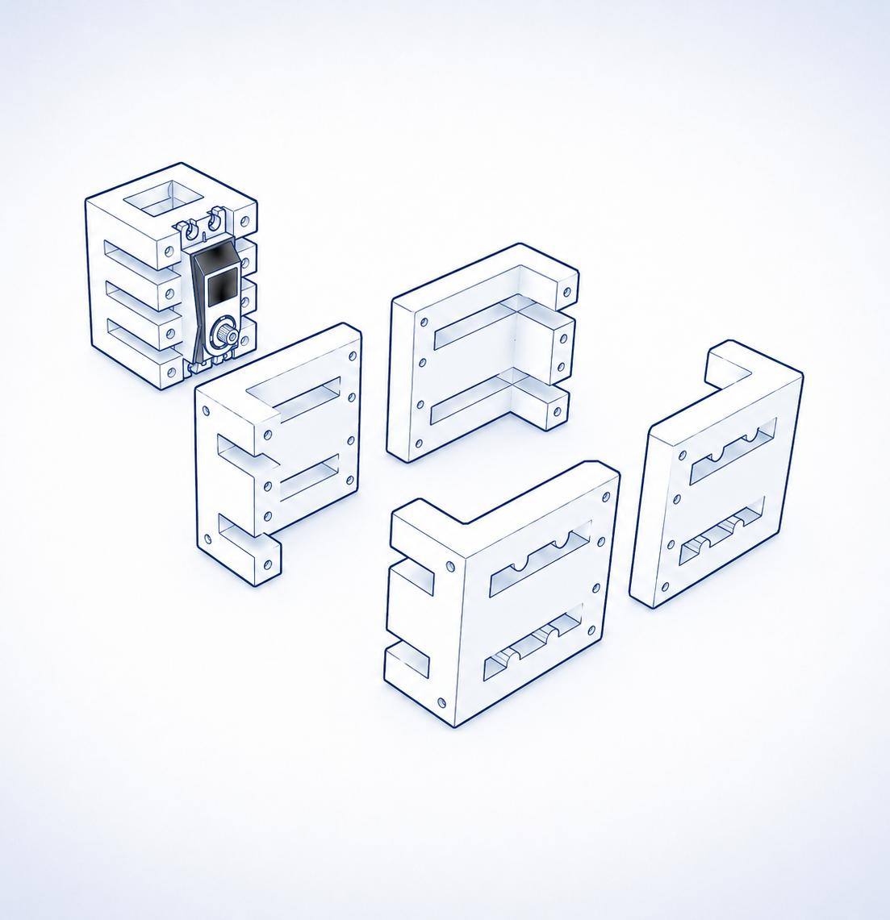
[picture p55: figure]

# ASSEMBLY INSTRUCTIONS

## HEAD FRAME

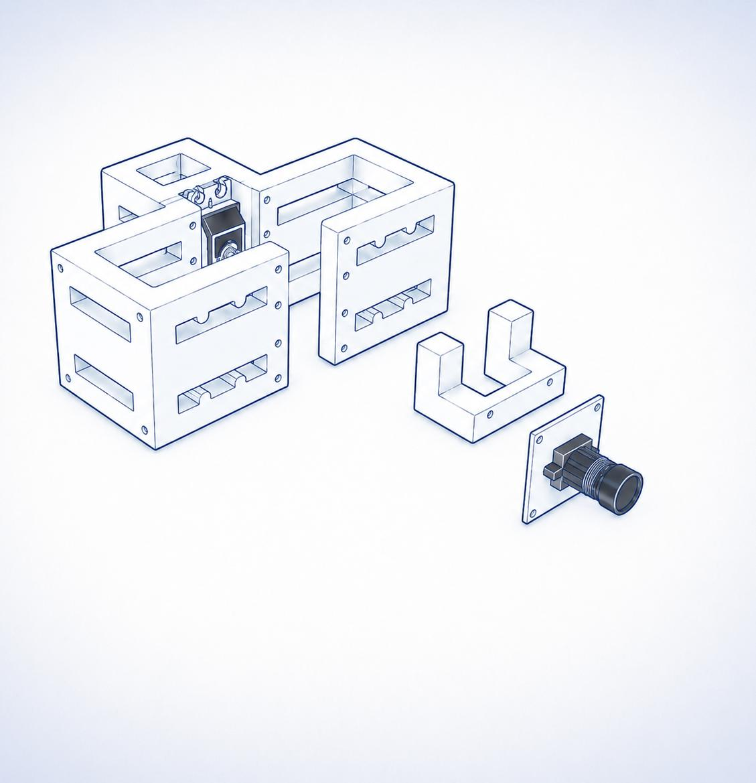
[picture p56: figure]

# ASSEMBLY INSTRUCTIONS

## LEGS AND BODY

Frame_Head_Camera_Holder

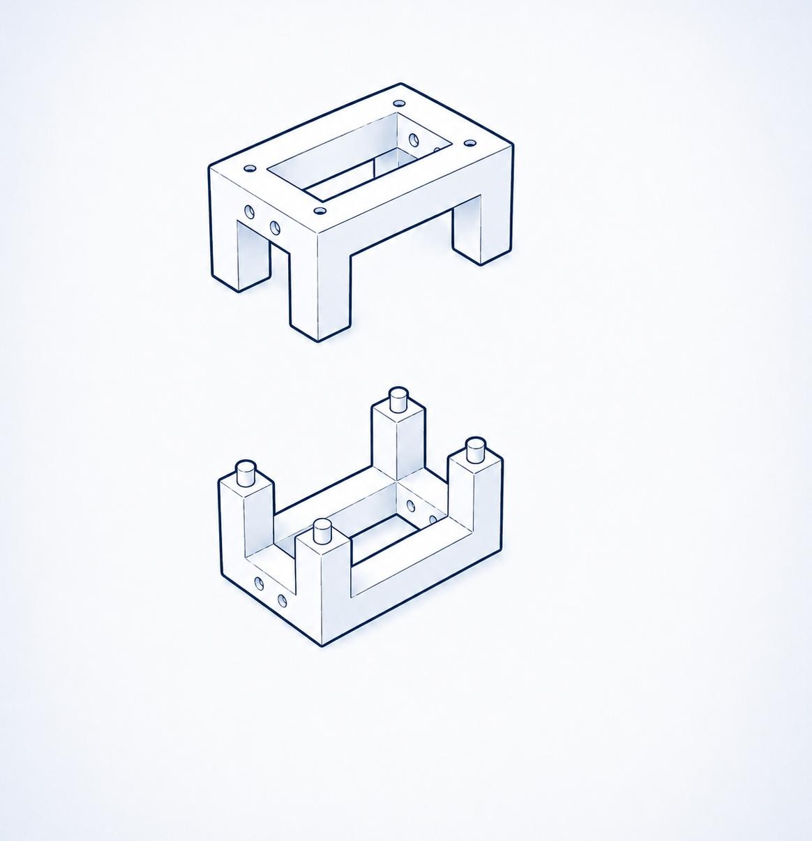
[picture p57: figure]

# ASSEMBLY INSTRUCTIONS

## BODY FRAME

Frame_Cage_Body_Bottom
Frame_Cage_Body_Top

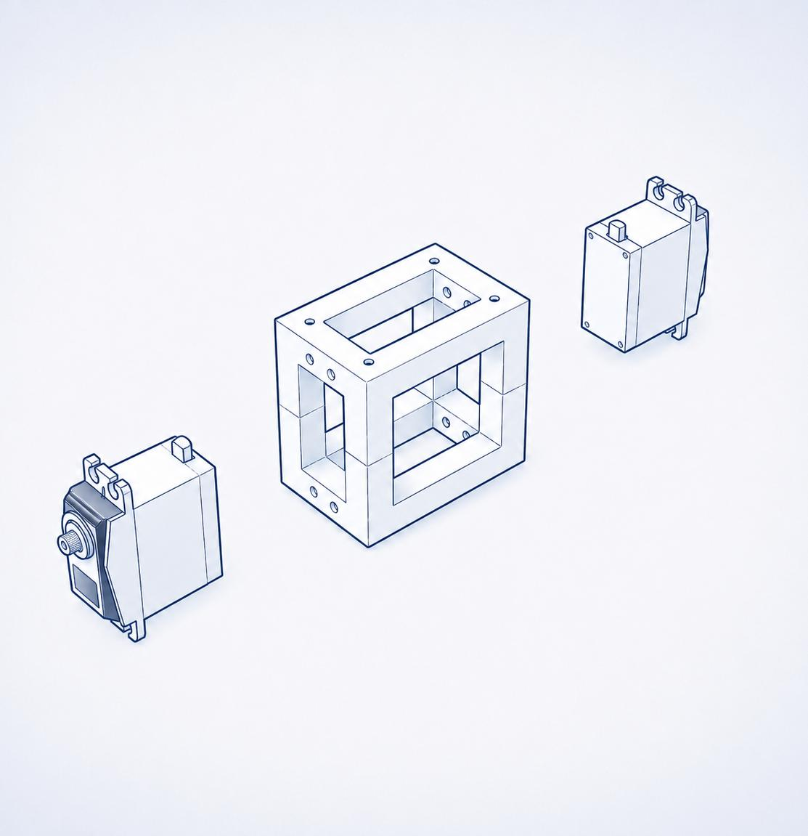
[picture p58: figure]

# ASSEMBLY INSTRUCTIONS

## BODY FRAME

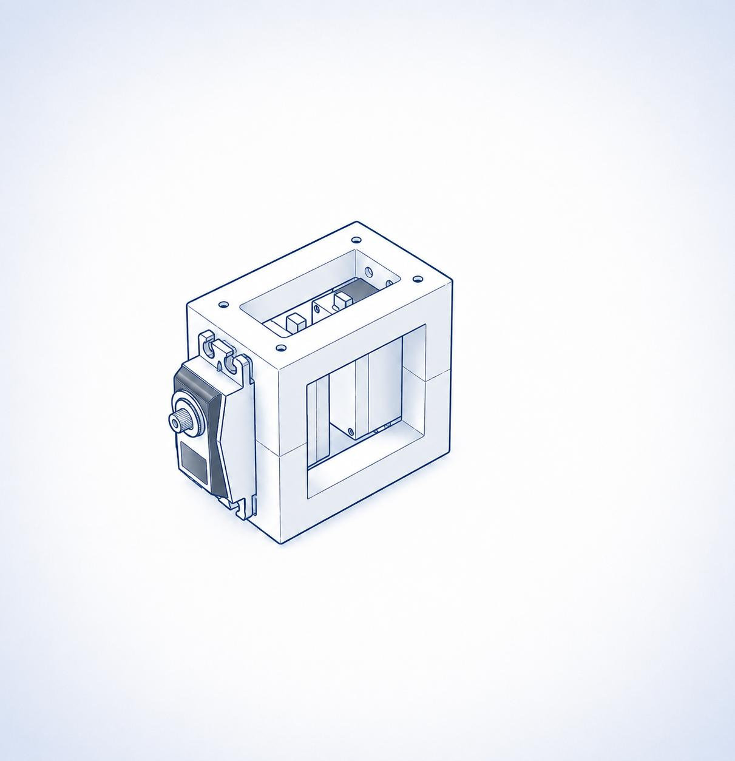
[picture p59: figure]

# ASSEMBLY INSTRUCTIONS

## BODY FRAME

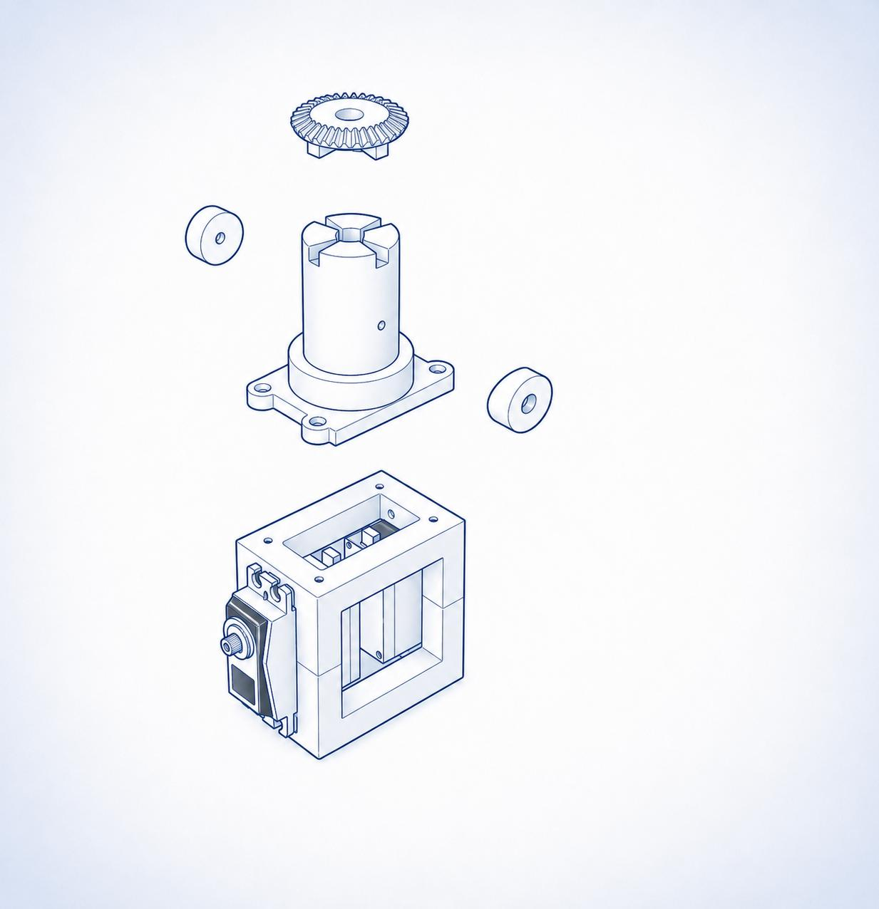
[picture p60: figure]

# ASSEMBLY INSTRUCTIONS

## BODY FRAME

Frame_Pole_Barrel_Back
Frame_Pole_Barrel_Front
Frame_Pole_White
Frame_Gear_36_teeth

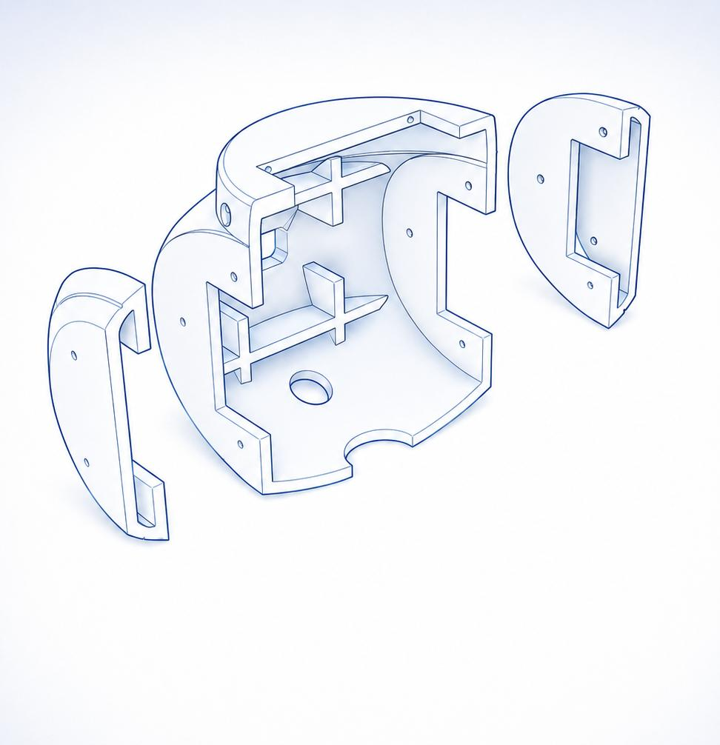
[picture p61: figure]

# ASSEMBLY INSTRUCTIONS

## HEAD

Head_Back_White
Head_Back_Left_White
Head_Back_Right_White

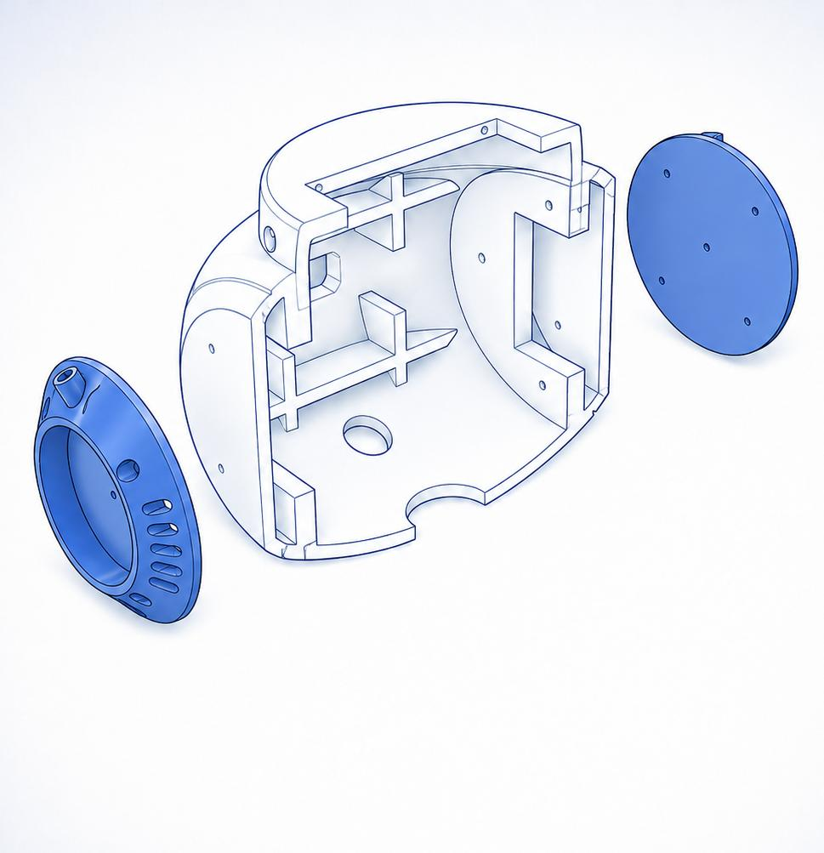
[picture p62: figure]

# ASSEMBLY INSTRUCTIONS

## HEAD

Head_Ear_Right_Blue
Head_Ear_Left_Blue

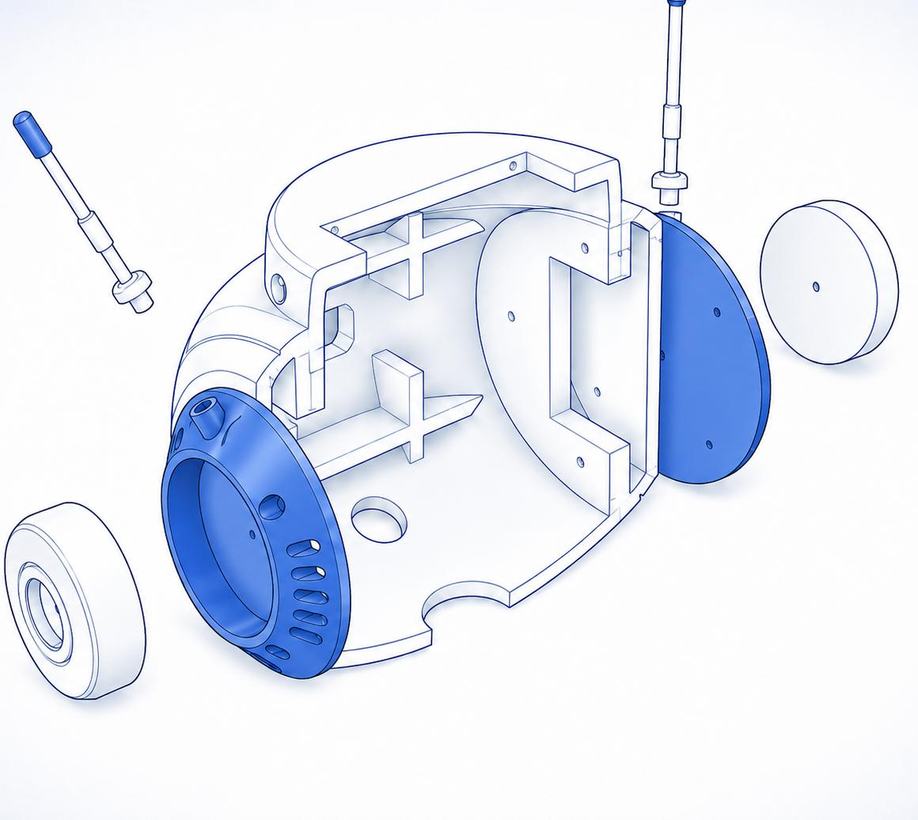
[picture p63: figure]

# ASSEMBLY INSTRUCTIONS

## HEAD

Head_Antenna_Cap_Left_Blue Head_Antenna_Cap_Right_Blue Head_Antenna_Left_White
Head_Antenna_Right_White
Head_Ear_Button_Left_White Head_Ear_Button_Right_White

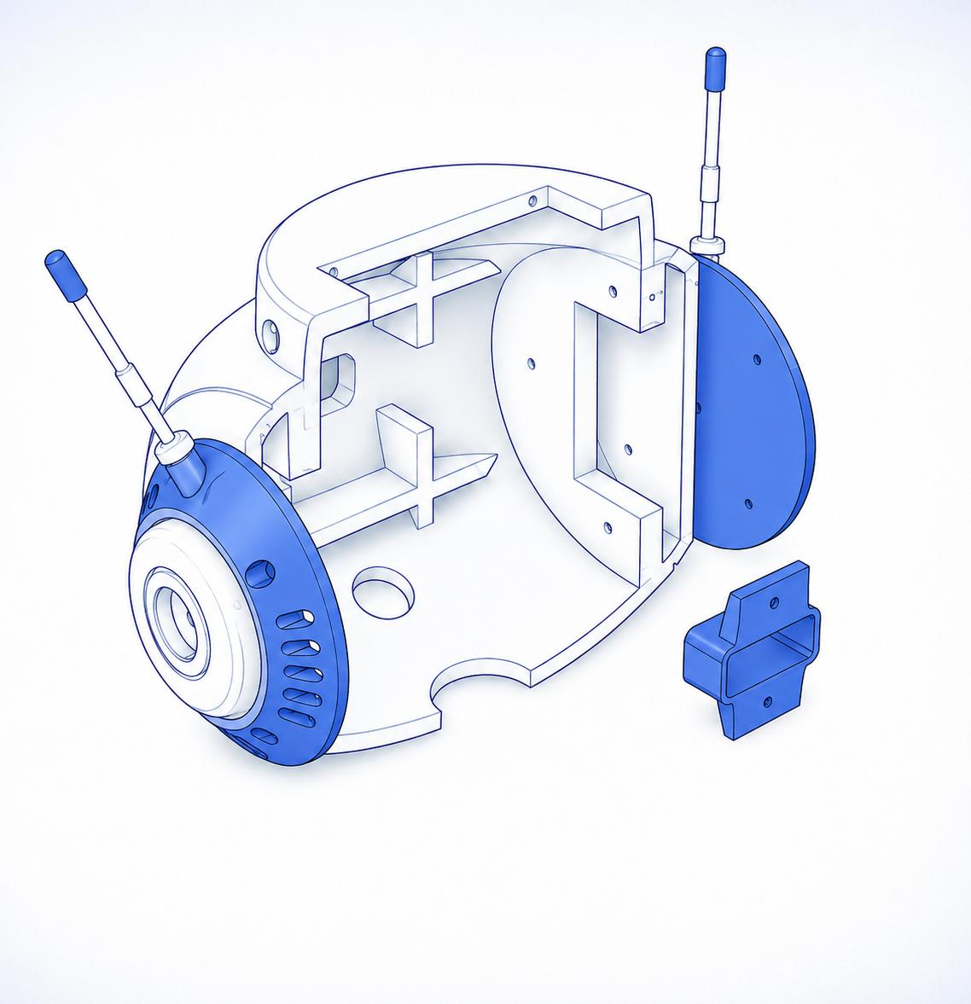
[picture p64: figure]

# ASSEMBLY INSTRUCTIONS

## HEAD

Head_Back_Ring_Blue

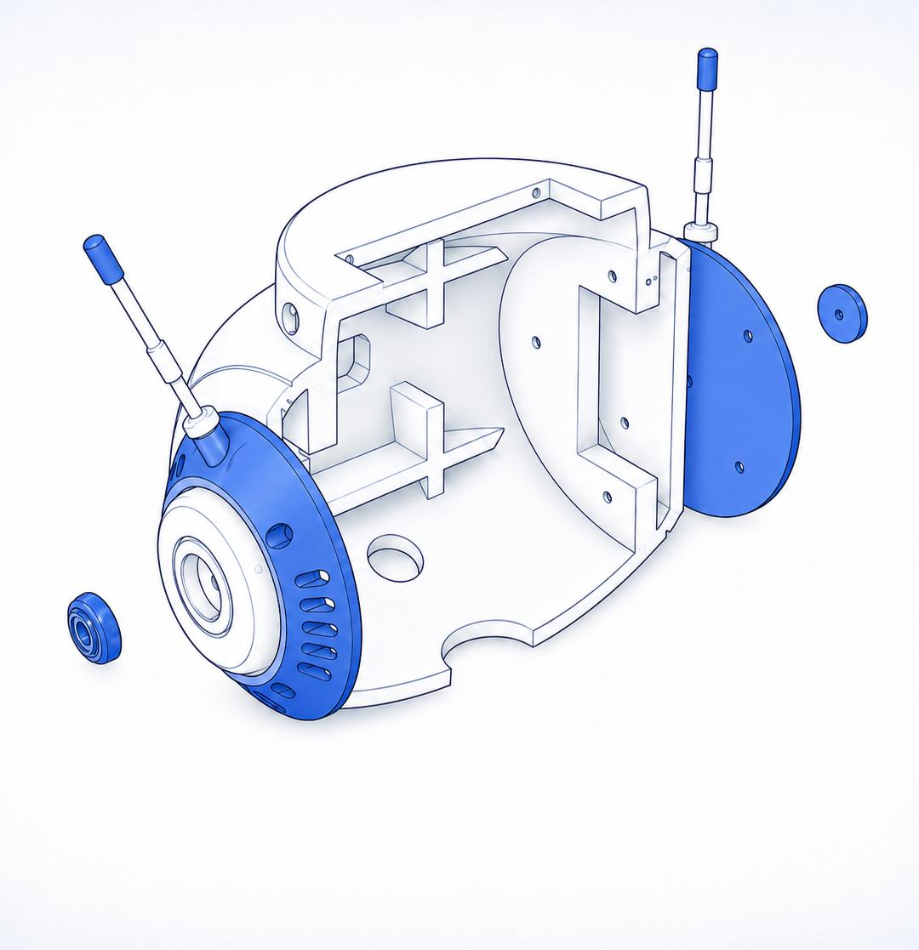
[picture p65: figure]

# ASSEMBLY INSTRUCTIONS

## HEAD

Head_Ear_Inside_Right_Blue Head_Ear_Inside_Left_Blue

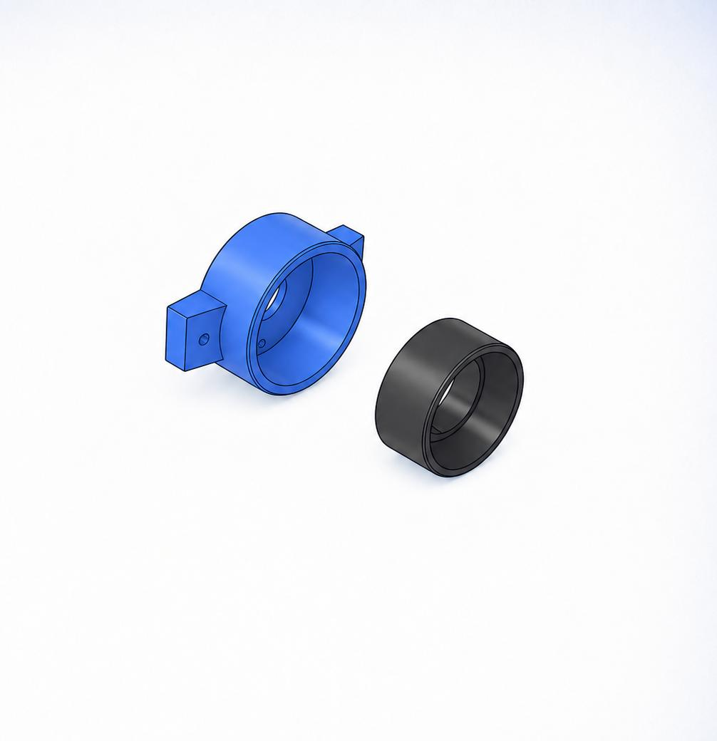
[picture p66: figure]

# ASSEMBLY INSTRUCTIONS

## CAMERA FRAME

Head_Camera_Lens_Black
Head_Camera_Lens_Ring_Blue

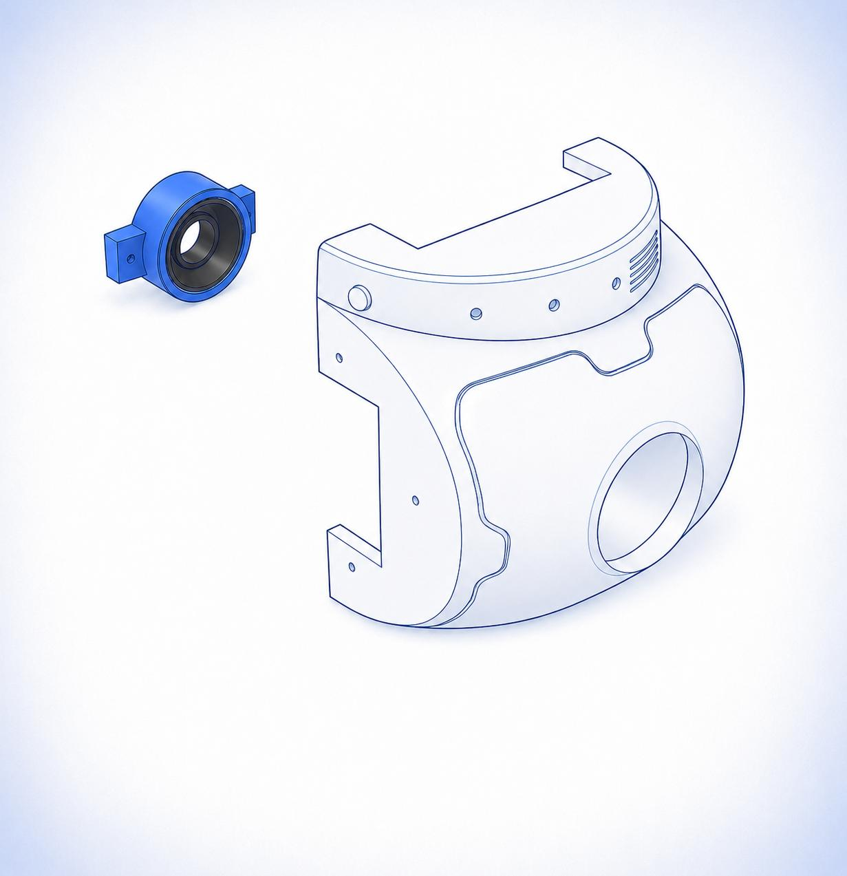
[picture p67: figure]

# ASSEMBLY INSTRUCTIONS

## HEAD

Head_Front_White

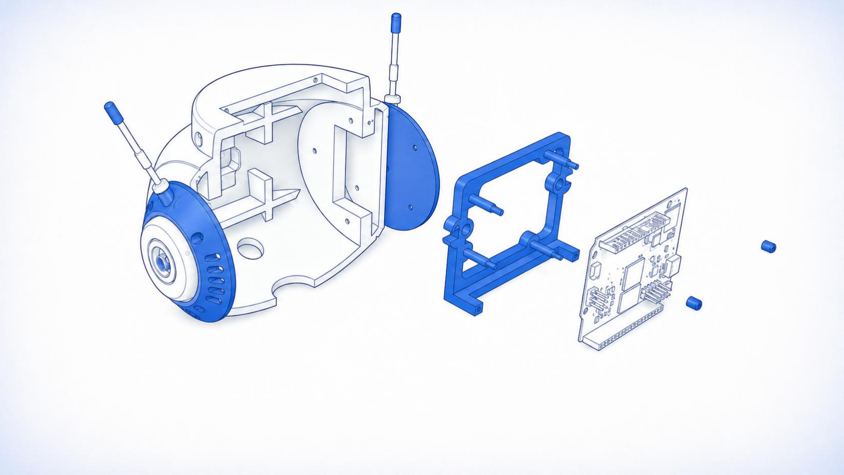
[picture p68: page 22]

# ASSEMBLY INSTRUCTIONS

## HEAD

Frame_Holder_Back_Blue
Frame_Holder_Back_Cap_Left_Blue

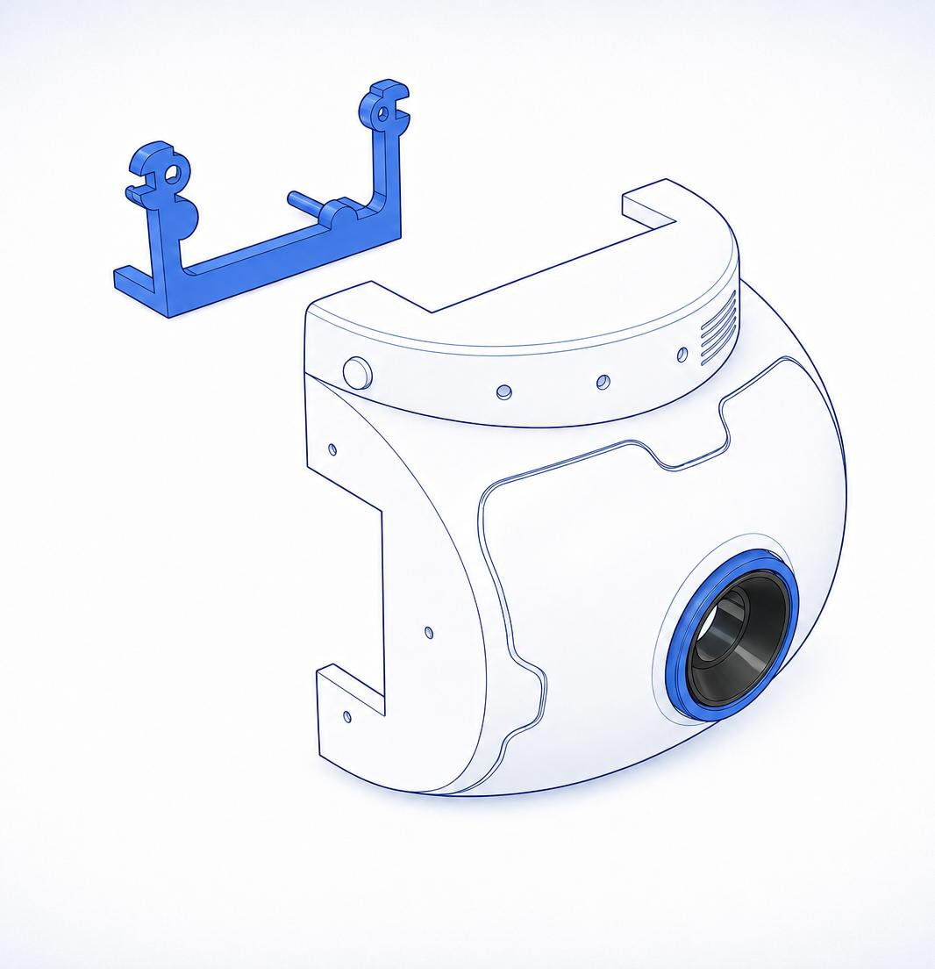
[picture p69: figure]

Frame_Holder_Back_Cap_Right_Blue Frame_Holder_Front_Blue

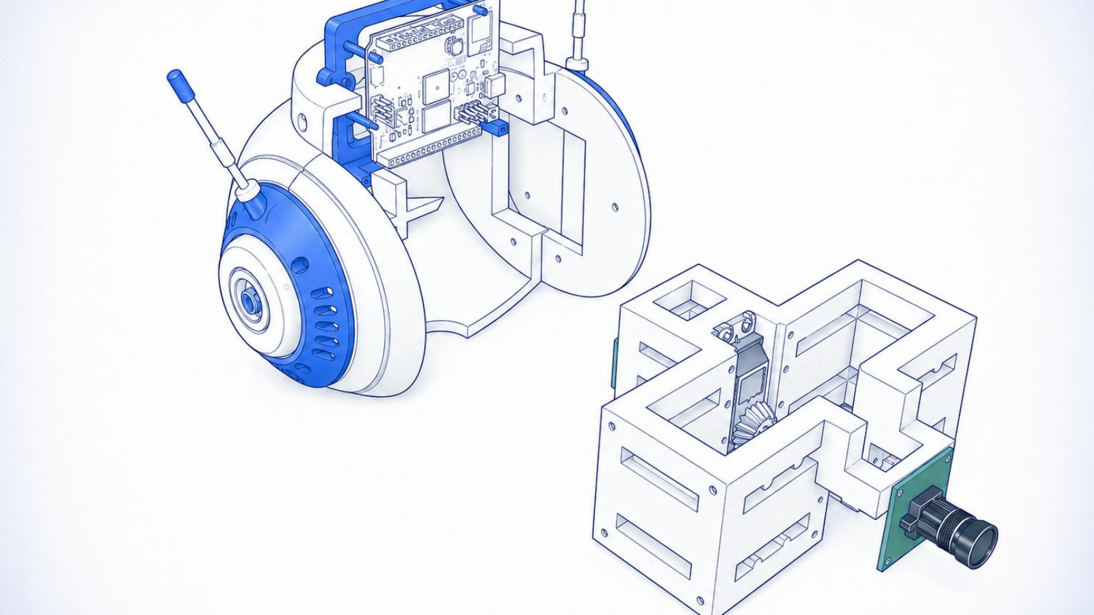
[picture p70: page 24]

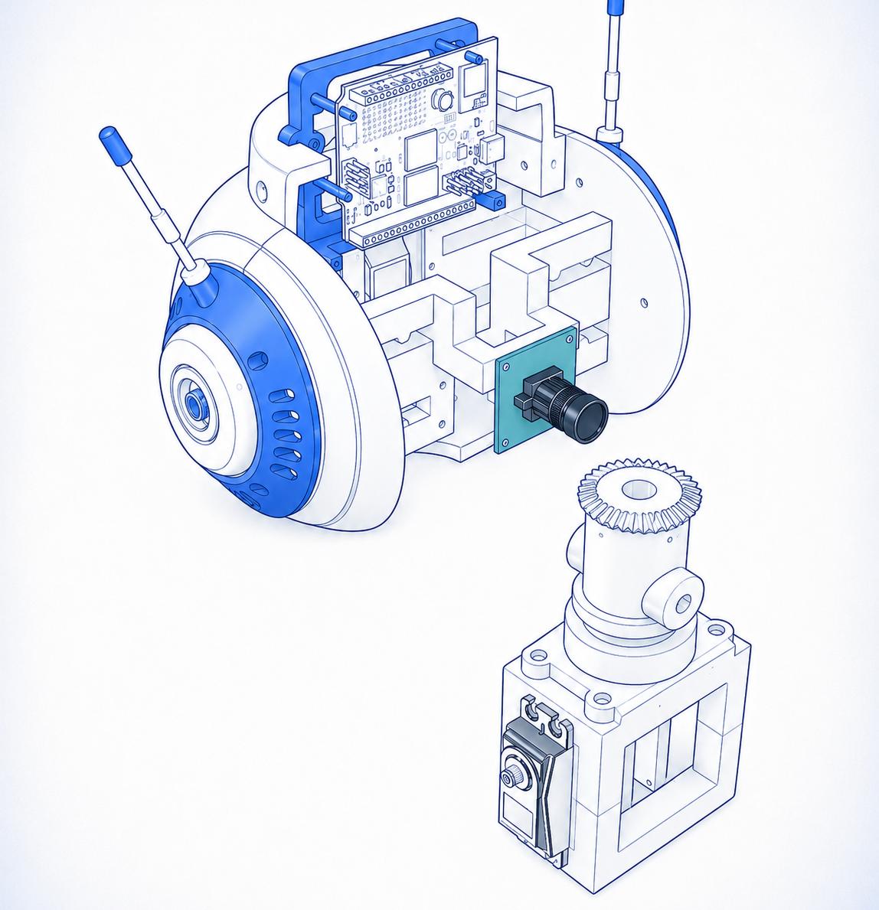
[picture p71: figure]

# ASSEMBLY INSTRUCTIONS

## HEAD AND BODY

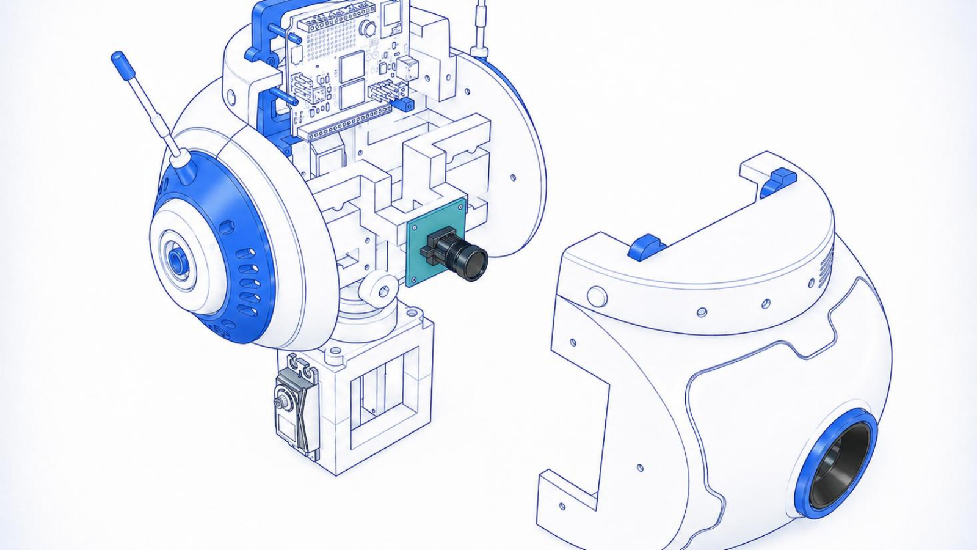
[picture p72: page 26]

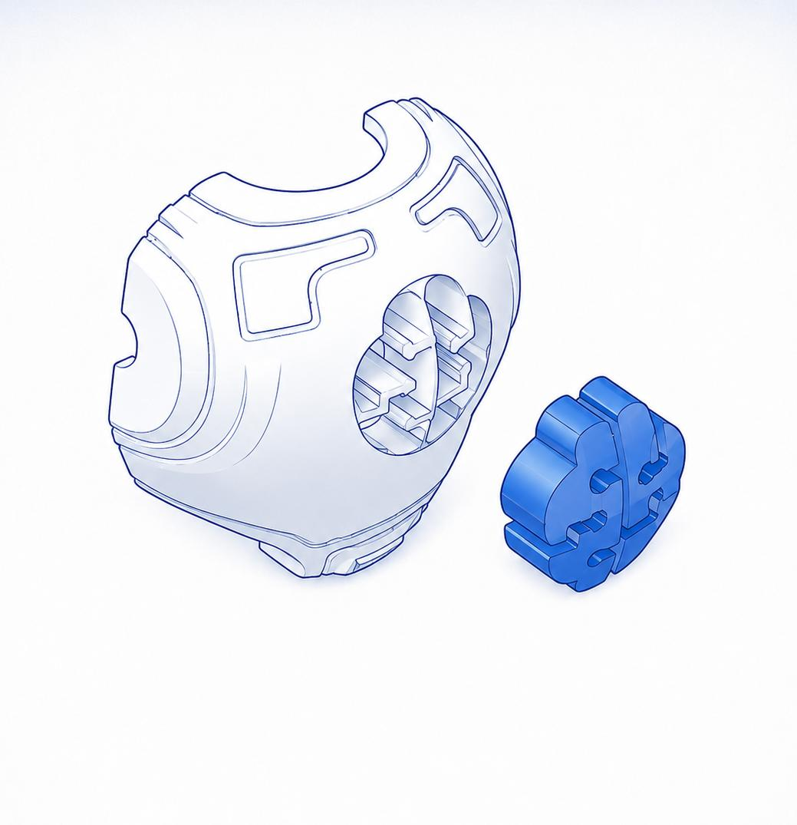
[picture p73: figure]

# ASSEMBLY INSTRUCTIONS

## BODY

Body_Frame_Front_White
Body_Logo_Left_Blue
Body_Logo_Right_Blue

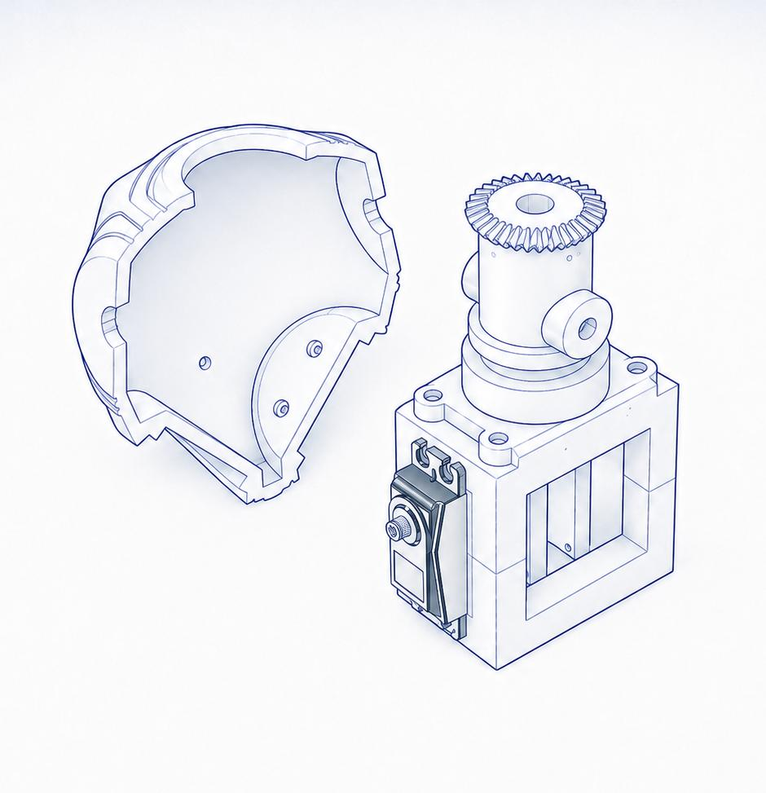
[picture p74: figure]

# ASSEMBLY INSTRUCTIONS

## BODY

Body_Frame_Back_White

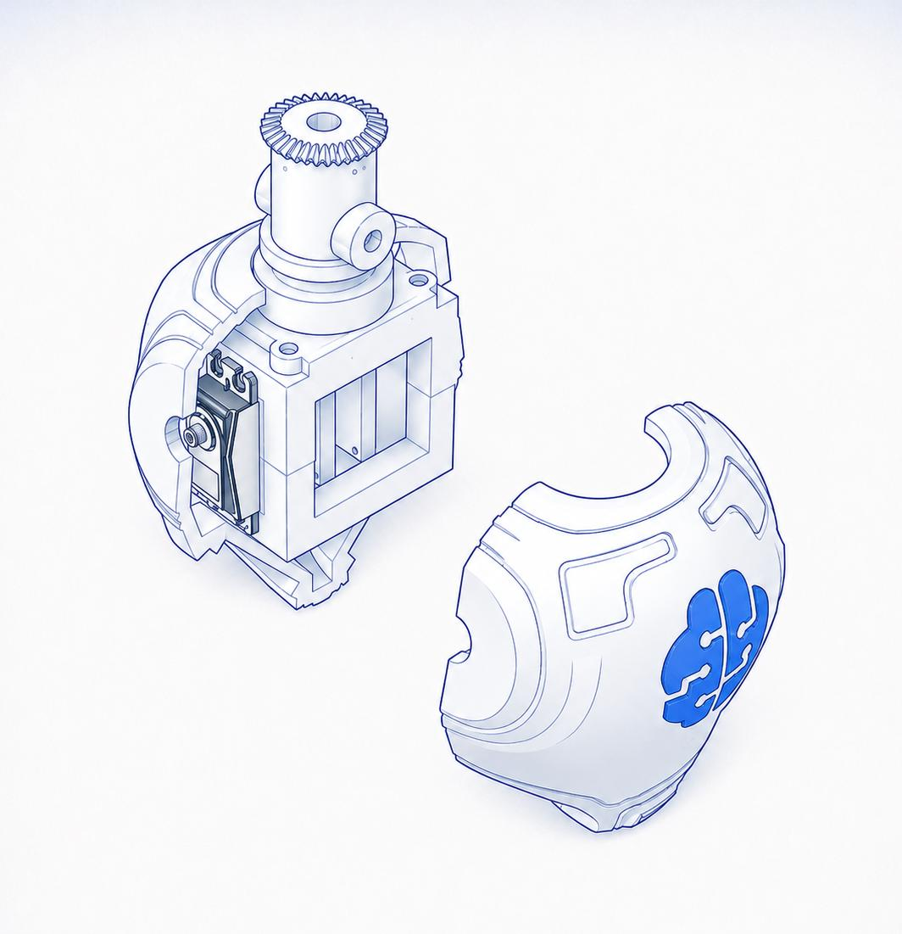
[picture p75: figure]

# ASSEMBLY INSTRUCTIONS

## BODY

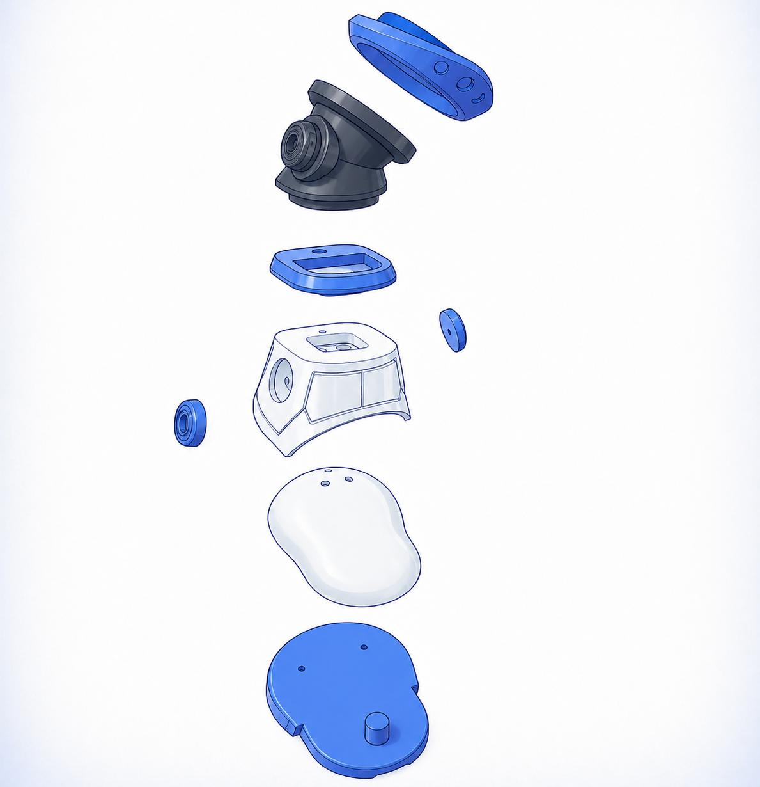
[picture p76: figure]

# ASSEMBLY INSTRUCTIONS

## LEGS x2

Right_Leg_Button_Left_Blue Right_Leg_Button_Right_Blue Right_Leg_Cap_White
Right_Leg_Knee_Black
Right_Leg_Knee_Ring_Blue
Right_Leg_Main_White
Right_Leg_Ring_Blue
Right_Leg_Base_Blue

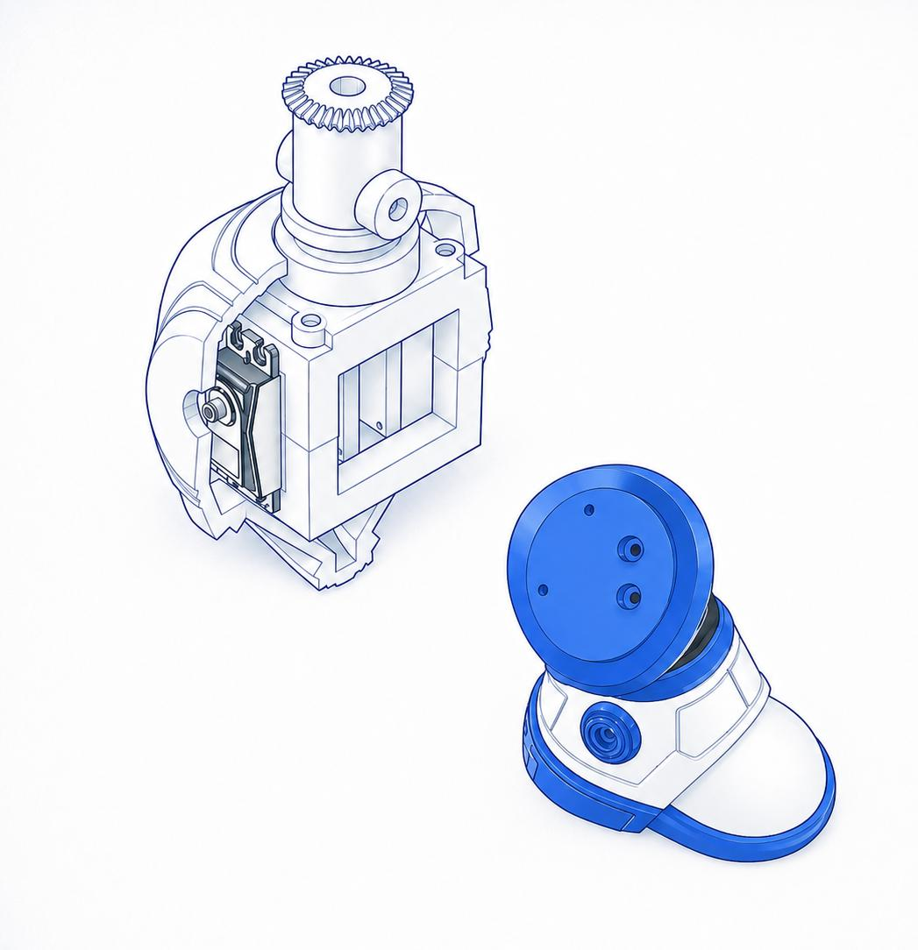
[picture p77: figure]

# ASSEMBLY INSTRUCTIONS

## LEGS AND BODY

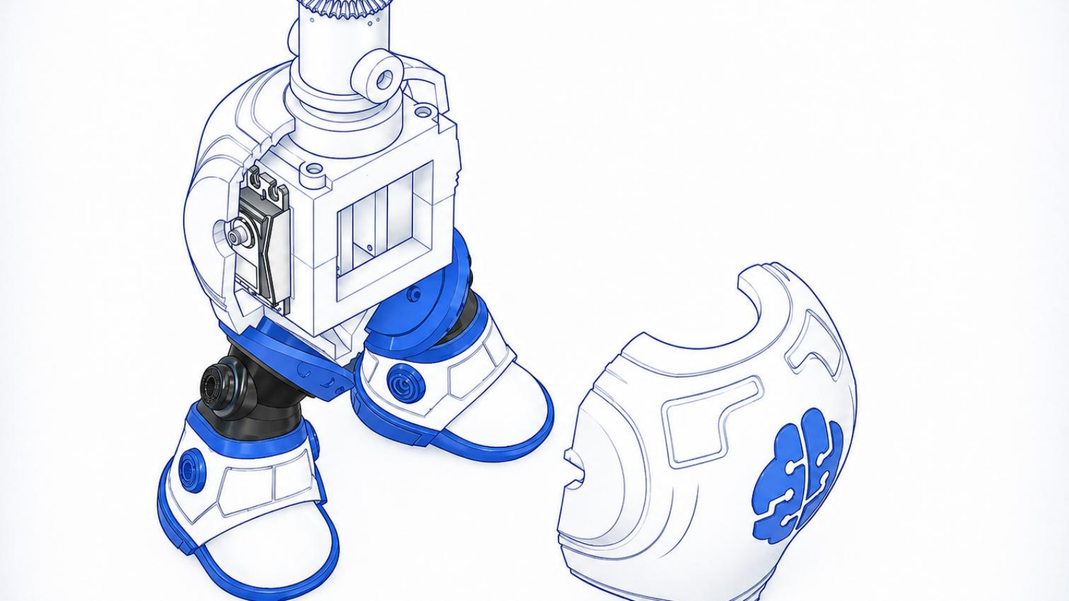
[picture p78: page 32]

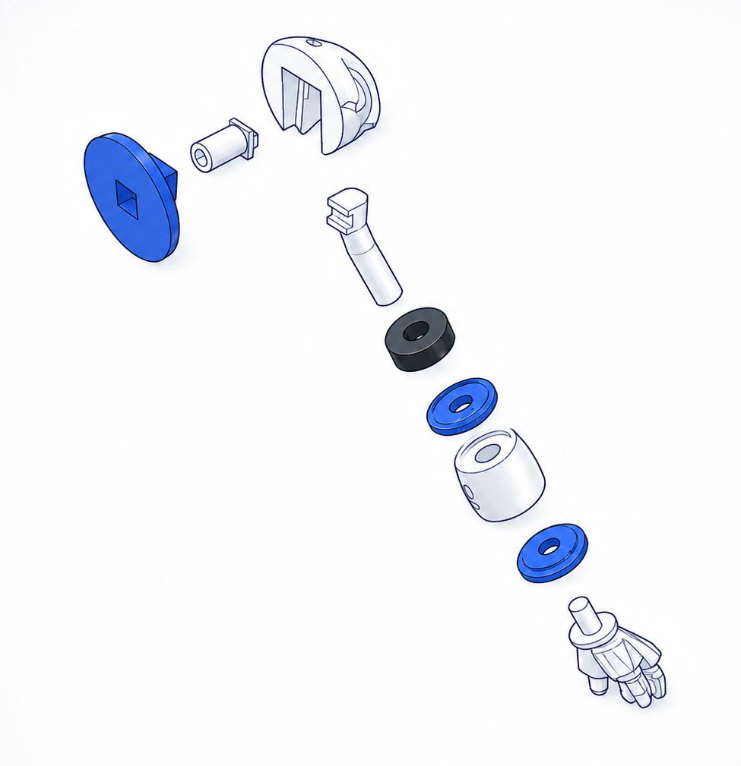
[picture p79: figure]

# ASSEMBLY INSTRUCTIONS

## HANDS x2

Left_Arm_Forearm_White
Left_Arm_Hand_Gray
Left_Arm_Ring_Bottom_Blue
Left_Arm_Ring_Top_Blue
Left_Arm_Shoulder_Joint
Left_Arm_Shoulder_Pole
Left_Arm_Shoulder_Ring_Blue Left_Arm_Shoulder_White
Left_Arm_Upper_Arm_Black

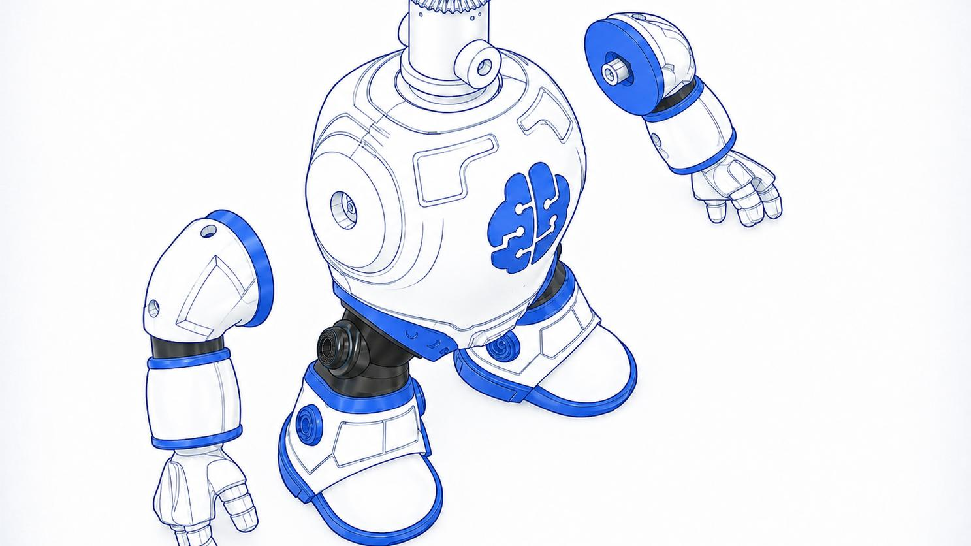
[picture p80: page 34]

# JBR-001

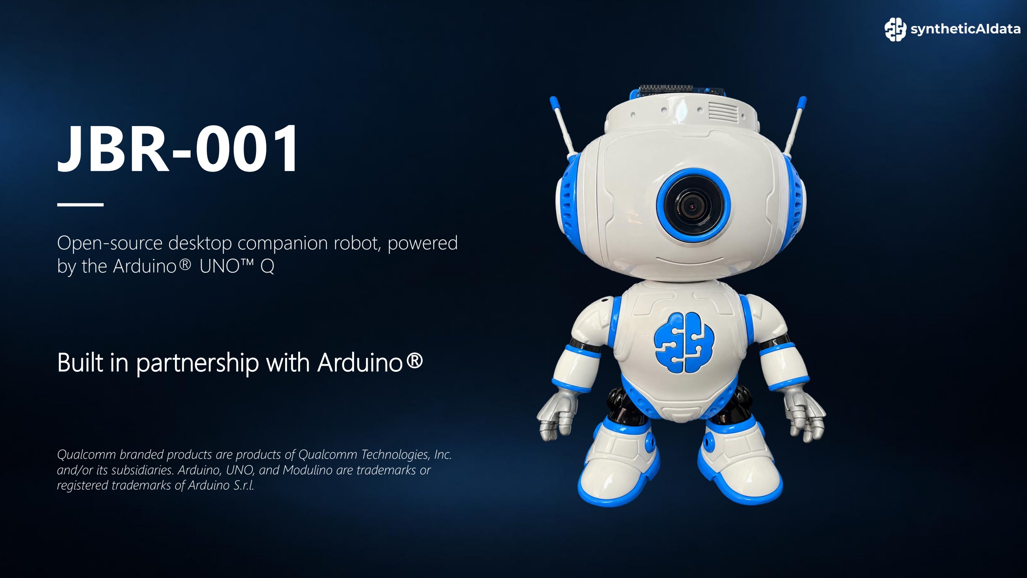
[picture p81: page 35]

Open-source desktop companion robot, powered by the Arduino® UNO Q

## Built in partnership with Arduino®

Qualcomm branded products are products of Qualcomm Technologies, Inc. and/or its subsidiaries. Arduino, UNO, and Modulino are trademarks or registered trademarks of Arduino S.r.l.
