syntheticAIdata/JBR-001/(commit log)

2026-09-22 Assembly Instructions PDF
2026-09-22 3D printable (STL) files
    [Body_Frame_Back_White.stl, Body_Frame_Front_White.stl, Body_Logo_Left_Blue.stl, Body_Logo_Right_Blue.stl, Frame_Cage_Body_Bottom.stl, Frame_Cage_Body_Top.stl, Frame_Gear_18_teeth.stl, Frame_Gear_36_teeth.stl]
2026-09-22 Hardware schematics
2026-10-07 Update 3D printable (STL) files
    [Body_Frame_Back_White.stl, Body_Frame_Front_White.stl, Frame_Cage_Body_Bottom.stl]
